Clyde2105/Thesis_FYP/Photos of Tests/Tests Photos/MediaPipe/Hand Landmarks working300.png

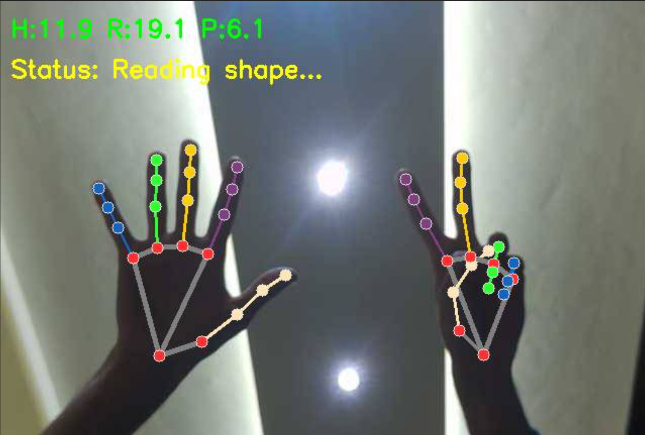
Photos of Tests/Tests Photos/MediaPipe/Hand Landmarks working300.png
