Clyde2105/Thesis_FYP/Photos of Tests/Tests Photos/Line/94aa3fa5-1989-4feb-a9e3-814e40652d71.jpg

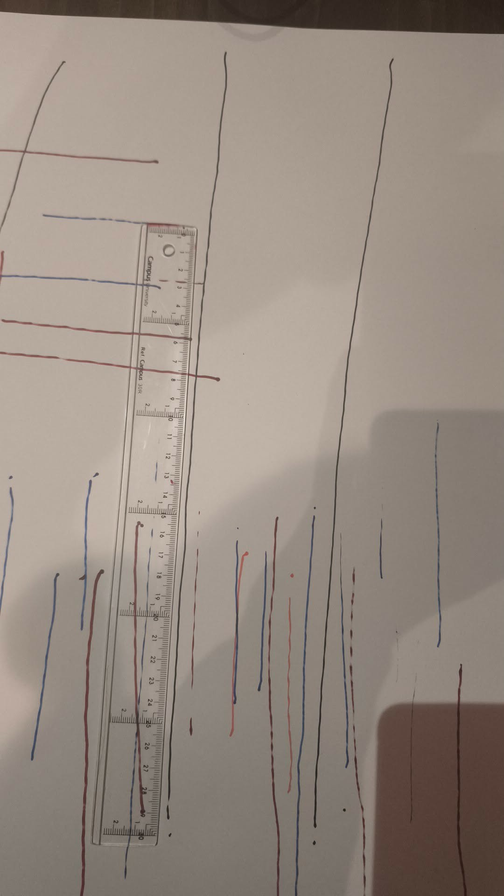
Photos of Tests/Tests Photos/Line/94aa3fa5-1989-4feb-a9e3-814e40652d71.jpg
