Clyde2105/Thesis_FYP/Photos of Tests/Tests Photos/Robot on Big Paper.jpg

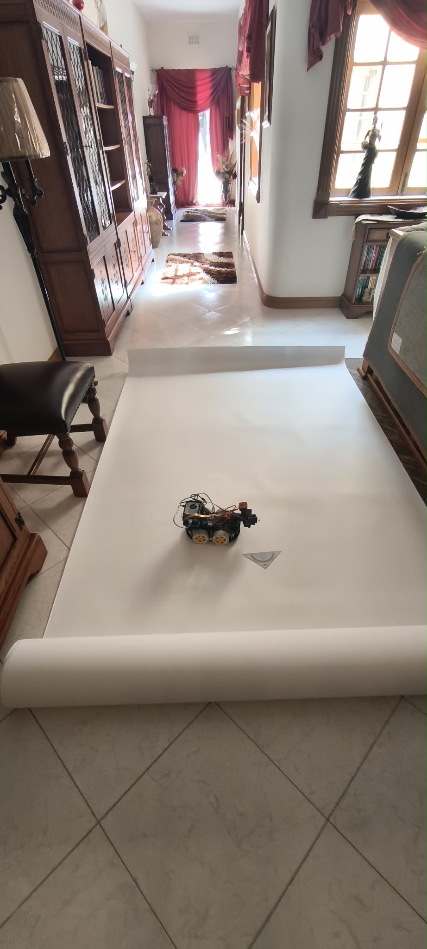
Photos of Tests/Tests Photos/Robot on Big Paper.jpg
