Clyde2105/Thesis_FYP/Photos of Tests/Tests Photos/measure shape setup.jpg

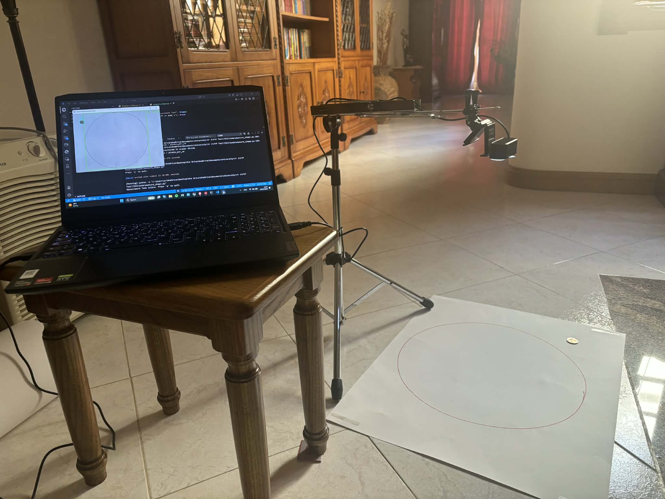
Photos of Tests/Tests Photos/measure shape setup.jpg
