Clyde2105/Thesis_FYP/Results/Thesis Results/Distance Test Results.xlsx

Distance (cm) | Trial Number | Intended Shape | Shape Read | Success (1 or 0) | Notes
30 | 1 | Circle | Circle | 1 | Stable - bit too close to the camera (45cm min is the best)
30 | 2 | Line | Line | 1 | Stable - bit too close to the camera (45cm min is the best)
30 | 3 | Rectangle | Rectangle | 1 | Stable - bit too close to the camera (45cm min is the best)
30 | 4 | Triangle | Triangle | 1 | Stable - bit too close to the camera (45cm min is the best)
30 | 5 | Square | Square | 1 | Stable - bit too close to the camera (45cm min is the best)
30 | 6 | Star | Star | 1 | Stable - bit too close to the camera (45cm min is the best) | Distance (X-Axis) | Accuracy % (Y-Axis)
60 | 1 | Circle | Circle | 1 | Stable | 30 | 100
60 | 2 | Line | Line | 1 | Stable | 60 | 100
60 | 3 | Rectangle | Rectangle | 1 | Stable | 90 | 100
60 | 4 | Triangle | Triangle | 1 | Stable | 120 | 100
60 | 5 | Square | Square | 1 | Stable | 200 | 100
60 | 6 | Star | Star | 1 | Stable | 300 | 100
90 | 1 | Circle | Circle | 1 | Stable
90 | 2 | Line | Line | 1 | Stable
90 | 3 | Rectangle | Rectangle | 1 | Stable
90 | 4 | Triangle | Triangle | 1 | Stable
90 | 5 | Square | Square | 1 | Stable
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
