Clyde2105/Thesis_FYP/Results/Thesis Results/BNO055/BNO055 Tests.xlsx

Time | Heading Angle | Target | Average | Min | Max | StdDev | Upper | Lower
0 | 0 | 0 | 0 | 0 | 0 | 0 | 0 | 0
0.5 | 0 | 30 | 28.75 | 28.75 | 28.75 | 0 | 0 | 0
1 | 0 | 60 | 59.12 | 59.12 | 59.12 | 0 | 0 | 0
1.5 | 0 | 90 | 89.12 | 89.12 | 89.12 | 0 | 0 | 0
2 | 0 | 120 | 118.25 | 118.25 | 118.25 | 0 | 0 | 0
2.5 | 0 | 150 | 147.5 | 147.5 | 147.5 | 0 | 0 | 0
3 | 0 | 180 | 178.01 | 177.94 | 178.06 | 0.06 | 0.05 | 0.07
3.5 | 0
4 | 0
4.5 | 0
5 | 0
5.5 | 0
6 | 0
6.5 | 0
7 | 0
7.5 | 0
8 | 0
8.5 | 0
9 | 0
9.5 | 0
10 | 0
10.5 | 0
11 | 0
11.5 | 0
12 | 0
12.6 | 0
13.1 | 0
13.6 | 0
14.1 | 0
14.6 | 0
15.1 | 0
15.6 | 0
16.1 | 0
16.6 | 0
17.1 | 0
17.6 | 0
18.1 | 0
18.6 | 0
19.1 | 0
19.6 | 0
20.1 | 0
20.6 | 0
21.1 | 0
21.6 | 0
22.1 | 0
22.6 | 0
23.1 | 0
23.6 | 0
24.1 | 0
24.6 | 0
25.1 | 0
25.6 | 0
26.1 | 0
26.6 | 0
27.1 | 0
27.6 | 0
28.1 | 0
28.6 | 0
29.1 | 0
29.6 | 0
30.1 | 0
30.6 | 0
31.1 | 0
31.6 | 0
32.1 | 0
32.6 | 0
33.1 | 0
33.6 | 0
34.1 | 0
34.6 | 0
35.1 | 0
35.6 | 0
36.1 | 0
36.7 | 0
37.2 | 0
37.7 | 0
38.2 | 0
38.7 | 0
39.2 | 0
39.7 | 0
40.2 | 0
40.7 | 0
41.2 | 0
41.7 | 0
42.2 | 0
42.7 | 0
43.2 | 0
43.7 | 0
44.2 | 0
44.7 | 0
45.2 | 0
45.7 | 0
46.2 | 0
46.7 | 0
47.2 | 0
47.7 | 0
48.2 | 0
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
