Clyde2105/Thesis_FYP/Results/Thesis Results/Gesture Accuracy Results.xlsx

Trial Number | Shape Given | Shape Read | Hand Gestures | Trial Number | Shape Given | Shape Read | Hand Gestures |  | Trial Number | Shape Given | Shape Read | Hand Gestures
1 | Circle | Circle | Fist - Palm Side - Physical | 1 | Line | Line | Thumb - Palm Side - Physical |  | 1 | Rectangle | Rectangle | Thumb + Index - Palm Side - Physical
2 | Circle | Circle | Fist - Palm Side - Physical | 2 | Line | Line | Index - Palm Side - Physical |  | 2 | Rectangle | Rectangle | Thumb + Middle - Palm Side - Physical
3 | Circle | Circle | Fist - Palm Side - Physical | 3 | Line | Line | Middle - Palm Side - Physical |  | 3 | Rectangle | Rectangle | Thumb + Ring - Palm Side - Physical
4 | Circle | Circle | Fist - Palm Side - Physical | 4 | Line | Line | Ring - Palm Side - Physical |  | 4 | Rectangle | Rectangle | Thumb + Pinky - Palm Side - Physical
5 | Circle | Circle | Fist - Palm Side - Physical | 5 | Line | Line | Pinky - Palm Side - Physical |  | 5 | Rectangle | Rectangle | Index + Middle - Palm Side - Physical
6 | Circle | Circle | Fist - Palm Side - Online | 6 | Line | Line | Thumb - Palm Side - Online |  | 6 | Rectangle | Rectangle | Index + Ring - Palm Side - Physical
7 | Circle | Circle | Fist - Palm Side - Online | 7 | Line | Line | Index - Palm Side - Online |  | 7 | Rectangle | Rectangle | Index + Pinky - Palm Side - Physical
8 | Circle | Circle | Fist - Palm Side - Online | 8 | Line | Line | Middle - Palm Side - Online |  | 8 | Rectangle | Rectangle | Middle + Ring - Palm Side - Physical
9 | Circle | Circle | Fist - Palm Side - Online | 9 | Line | Line | Ring - Palm Side - Online |  | 9 | Rectangle | Rectangle | Middle + Pinky - Palm Side - Physical
10 | Circle | Circle | Fist - Palm Side - Online | 10 | Line | Line | Pinky - Palm Side - Online |  | 10 | Rectangle | Rectangle | Ring + Pinky - Palm Side - Physical
11 | Circle | Line | Fist - Back Side - Physical | 11 | Line | Circle | Thumb - Back Side - Physical |  | 11 | Rectangle | Rectangle | Thumb + Index - Palm Side - Online
12 | Circle | Line | Fist - Back Side - Physical | 12 | Line | Rectangle | Index - Back Side - Physical |  | 12 | Rectangle | Rectangle | Thumb + Middle - Palm Side - Online
13 | Circle | Line | Fist - Back Side - Physical | 13 | Line | Rectangle | Middle - Back Side - Physical |  | 13 | Rectangle | Rectangle | Thumb + Ring - Palm Side - Online
14 | Circle | Line | Fist - Back Side - Physical | 14 | Line | Rectangle | Ring - Back Side - Physical |  | 14 | Rectangle | Rectangle | Thumb + Pinky - Palm Side - Online
15 | Circle | Line | Fist - Back Side - Physical | 15 | Line | Rectangle | Pinky - Back Side - Online |  | 15 | Rectangle | Rectangle | Index + Middle - Palm Side - Online
16 | Circle | Line | Fist - Back Side - Online | 16 | Line | Circle | Thumb - Back Side - Online |  | 16 | Rectangle | Rectangle | Index + Ring - Palm Side - Online
17 | Circle | Line | Fist - Back Side - Online | 17 | Line | Rectangle | Index - Back Side - Online |  | 17 | Rectangle | Rectangle | Index + Pinky - Palm Side - Online
18 | Circle | Line | Fist - Back Side - Online | 18 | Line | Rectangle | Middle - Back Side - Online |  | 18 | Rectangle | Rectangle | Middle + Ring - Palm Side - Online
19 | Circle | Line | Fist - Back Side - Online | 19 | Line | Rectangle | Ring - Back Side - Online |  | 19 | Rectangle | Rectangle | Middle + Pinky - Palm Side - Online
20 | Circle | Line | Fist - Back Side - Online | 20 | Line | Rectangle | Pinky - Back Side - Online |  | 20 | Rectangle | Rectangle | Ring + Pinky - Palm Side - Online
 |  |  |  |  |  |  |  |  | 21 | Rectangle | Line | Thumb + Pinky - Back Side - Physical
 |  |  |  |  |  |  |  |  | 22 | Rectangle | Triangle | Index + Middle - Back Side - Physical
 |  |  |  |  |  |  |  |  | 23 | Rectangle | Line | Thumb + Middle - Back Side - Physical
 |  |  |  |  |  |  |  |  | 24 | Rectangle | Square | Index + Ring - Back Side - Physical
 |  |  |  |  |  |  |  |  | 25 | Rectangle | Triangle | Middle + Pinky - Back Side - Physical
Trial Number | Shape Given | Shape Read | Hand Gestures | Trial Number | Shape Given | Shape Read | Hand Gestures |  | Trial Number | Shape Given | Shape Read | Hand Gestures
1 | Triangle | Triangle | Thumb + Index + Middle - Palm Side - Physical | 1 | Square | Square | Thumb + Index + Middle + Ring - Palm Side - Physical |  | 1 | Star | Star | Open Hand - Palm Side - Physical
2 | Triangle | Triangle | Thumb + Index + Ring - Palm Side - Physical | 2 | Square | Square | Thumb + Index + Middle + Pinky - Palm Side - Physical |  | 2 | Star | Star | Open Hand - Palm Side - Physical
3 | Triangle | Triangle | Thumb + Index + Pinky - Palm Side - Physical | 3 | Square | Square | Thumb + Index + Ring + Pinky - Palm Side - Physical |  | 3 | Star | Star | Open Hand - Palm Side - Physical
4 | Triangle | Triangle | Thumb + Middle + Ring - Palm Side - Physical | 4 | Square | Square | Thumb + Middle + Ring + Pinky - Palm Side - Physical |  | 4 | Star | Star | Open Hand - Palm Side - Physical
5 | Triangle | Triangle | Thumb + Middle + Pinky - Palm Side - Physical | 5 | Square | Square | Index + Middle + Ring + Pinky - Palm Side - Physical |  | 5 | Star | Star | Open Hand - Palm Side - Physical
6 | Triangle | Triangle | Thumb + Ring + Pinky - Palm Side - Physical | 6 | Square | Square | Thumb + Index + Middle + Ring - Palm Side - Online |  | 6 | Star | Star | Open Hand - Palm Side - Online
7 | Triangle | Triangle | Index + Middle + Ring - Palm Side - Physical | 7 | Square | Square | Thumb + Index + Middle + Pinky - Palm Side - Online |  | 7 | Star | Star | Open Hand - Palm Side - Online
8 | Triangle | Triangle | Index + Middle + Pinky - Palm Side - Physical | 8 | Square | Square | Thumb + Index + Ring + Pinky - Palm Side - Online |  | 8 | Star | Star | Open Hand - Palm Side - Online
9 | Triangle | Triangle | Index + Ring + Pinky - Palm Side - Physical | 9 | Square | Square | Thumb + Middle + Ring + Pinky - Palm Side - Online |  | 9 | Star | Star | Open Hand - Palm Side - Online
10 | Triangle | Triangle | Middle + Ring + Pinky - Palm Side - Physical | 10 | Square | Square | Index + Middle + Ring + Pinky - Palm Side - Online |  | 10 | Star | Star | Open Hand - Palm Side - Online
11 | Triangle | Triangle | Thumb + Index + Middle - Palm Side - Online | 11 | Square | Square | Thumb + Index + Middle + Ring - Back Side - Physical |  | 11 | Star | Square | Open Hand - Back Side - Physical
12 | Triangle | Triangle | Thumb + Index + Ring - Palm Side - Online | 12 | Square | Triangle | Thumb + Index + Middle + Pinky - Back Side - Physical |  | 12 | Star | Square | Open Hand - Back Side - Physical
13 | Triangle | Triangle | Thumb + Index + Pinky - Palm Side - Online | 13 | Square | Triangle | Thumb + Index + Ring + Pinky - Back Side - Physical |  | 13 | Star | Square | Open Hand - Back Side - Physical
14 | Triangle | Triangle | Thumb + Middle + Ring - Palm Side - Online | 14 | Square | Triangle | Thumb + Middle + Ring + Pinky - Back Side - Physical |  | 14 | Star | Square | Open Hand - Back Side - Physical
15 | Triangle | Triangle | Thumb + Middle + Pinky - Palm Side - Online | 15 | Square | Star | Index + Middle + Ring + Pinky - Back Side - Physical |  | 15 | Star | Square | Open Hand - Back Side - Physical
16 | Triangle | Triangle | Thumb + Ring + Pinky - Palm Side - Online | 16 | Square | Square | Thumb + Index + Middle + Ring - Back Side - Online |  | 16 | Star | Square | Open Hand - Back Side - Online
17 | Triangle | Triangle | Index + Middle + Ring - Palm Side - Online | 17 | Square | Triangle | Thumb + Index + Middle + Pinky - Back Side - Online |  | 17 | Star | Square | Open Hand - Back Side - Online
18 | Triangle | Triangle | Index + Middle + Pinky - Palm Side - Online | 18 | Square | Triangle | Thumb + Index + Ring + Pinky - Back Side - Online |  | 18 | Star | Square | Open Hand - Back Side - Online
19 | Triangle | Triangle | Index + Ring + Pinky - Palm Side - Online | 19 | Square | Triangle | Thumb + Middle + Ring + Pinky - Back Side - Online |  | 19 | Star | Square | Open Hand - Back Side - Online
20 | Triangle | Triangle | Middle + Ring + Pinky - Palm Side - Online | 20 | Square | Star | Index + Middle + Ring + Pinky - Back Side - Online |  | 20 | Star | Square | Open Hand - Back Side - Online
21 | Triangle | Rectangle | Thumb + Index + Middle - Back Side - Physical
22 | Triangle | Rectangle | Thumb + Index + Ring - Back Side - Physical
23 | Triangle | Rectangle | Thumb + Index + Pinky - Back Side - Physical
24 | Triangle | Rectangle | Thumb + Middle + Ring - Back Side - Physical
25 | Triangle | Rectangle | Thumb + Middle + Pinky - Back Side - Physical |  | Actual \ Predicted | Circle | Line | Rectangle | Triangle | Square | Star | Total Trials
26 | Triangle | Rectangle | Thumb + Ring + Pinky - Back Side - Physical |  | Circle (0) | 10 | 10 | 0 | 0 | 0 | 0 | 20
27 | Triangle | Square | Index + Middle + Ring - Back Side - Physical |  | Line (1) | 2 | 10 | 8 | 0 | 0 | 0 | 20
28 | Triangle | Square | Index + Middle + Pinky - Back Side - Physical |  | Rectangle (2) | 0 | 2 | 20 | 2 | 1 | 0 | 25
29 | Triangle | Square | Index + Ring + Pinky - Back Side - Physical |  | Triangle (3) | 0 | 0 | 6 | 20 | 4 | 0 | 30
30 | Triangle | Square | Middle + Ring + Pinky - Back Side - Physical |  | Square (4) | 0 | 0 | 0 | 6 | 12 | 2 | 20
 |  |  |  |  | Star (5) | 0 | 0 | 0 | 0 | 10 | 10 | 20
(Back of Hand showing, reads thumb incorrectly and adds one to readings) |  |  |  |  | Total Predicted | 12 | 22 | 34 | 28 | 27 | 12 | 135
For example, 0 fingers up with back hand is Line since it misclassifies as thumb up!
