Clyde2105/Thesis_FYP/Results/Thesis Results/LM393/LM393 Tests.xlsx

Time (ms) | LeftTicks | RightTicks | LeftVelocity | RightVelocity | Sample No. | Test 1 Left Ticks | Test 1 Right Ticks | Test 2 Left Ticks | Test 2 Right Ticks | Test 3 Left Ticks | Test 3 Right Ticks | Test 4 Left Ticks | Test 4 Right Ticks | Test 5 Left Ticks | Test 5 Right Ticks
0 | 0 | 0 | 0 | 0 | 1 | 0 | 0 | 0 | 0 | 0 | 0 | 0 | 0 | 0 | 0
100 | 2 | 4 | 2 | 4 | 2 | 0 | 0 | 0 | 0 | 0 | 0 | 0 | 0 | 2 | 0
200 | 6 | 8 | 4 | 4 | 3 | 0 | 0 | 1 | 1 | 1 | 1 | 1 | 1 | 2 | 0
300 | 10 | 12 | 4 | 4 | 4 | 0 | 0 | 1 | 1 | 1 | 1 | 1 | 1 | 2 | 0
400 | 14 | 16 | 4 | 4 | 5 | 1 | 1 | 2 | 2 | 2 | 1 | 2 | 2 | 3 | 0
500 | 19 | 23 | 5 | 7 | 6 | 1 | 1 | 2 | 3 | 3 | 1 | 2 | 2 | 3 | 0
600 | 25 | 27 | 6 | 4 | 7 | 1 | 1 | 2 | 3 | 3 | 2 | 2 | 2 | 3 | 0
700 | 33 | 31 | 8 | 4 | 8 | 2 | 2 | 3 | 4 | 4 | 3 | 3 | 3 | 4 | 1
800 | 39 | 35 | 6 | 4 | 9 | 3 | 2 | 3 | 4 | 4 | 3 | 4 | 3 | 4 | 1
900 | 46 | 39 | 7 | 4 | 10 | 4 | 3 | 4 | 5 | 5 | 4 | 5 | 4 | 4 | 1
1000 | 50 | 44 | 4 | 5 | 11 | 4 | 3 | 4 | 6 | 5 | 4 | 5 | 4 | 5 | 2
1100 | 54 | 48 | 4 | 4 | 12 | 4 | 3 | 4 | 6 | 5 | 5 | 5 | 4 | 5 | 2
1200 | 59 | 53 | 5 | 5 | 13 | 5 | 4 | 5 | 7 | 6 | 6 | 6 | 5 | 6 | 2
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
