Clyde2105/Thesis_FYP/Results/Thesis Results/Light Intensity Test Results.xlsx

Lighting Condition | Trial Number | Intended Shape | Shape Read | Success (1 or 0) | Notes | Lighting Condition | Accuracy (%)
Fully Lit | 1 | Circle | Circle | 1 | Stable | Fully Lit (Standard) | 100%
Fully Lit | 2 | Line | Line | 1 | Stable | Background Lit (Backlit) | 100%
Fully Lit | 3 | Rectangle | Rectangle | 1 | Stable | Dimmly Lit (Low Light) | 0%
Fully Lit | 4 | Triangle | Triangle | 1 | Stable
Fully Lit | 5 | Square | Square | 1 | Stable
Fully Lit | 6 | Star | Star | 1 | Stable
Dimmly Lit | 1 | Circle | Nothing | 0 | Not stable - barely reading one hand
Dimmly Lit | 2 | Line | Nothing | 0 | Not stable - barely reading one hand
Dimmly Lit | 3 | Rectangle | Nothing | 0 | Not stable - barely reading one hand
Dimmly Lit | 4 | Triangle | Nothing | 0 | Not stable - barely reading one hand
Dimmly Lit | 5 | Square | Nothing | 0 | Not stable - barely reading one hand
Dimmly Lit | 6 | Star | Nothing | 0 | Not stable - barely reading one hand
Background Lit | 1 | Circle | Circle | 1 | Stable
Background Lit | 2 | Line | Line | 1 | Stable
Background Lit | 3 | Rectangle | Rectangle | 1 | Stable
Background Lit | 4 | Triangle | Triangle | 1 | Stable
Background Lit | 5 | Square | Square | 1 | Stable
Background Lit | 6 | Star | Star | 1 | Stable
