Clyde2105/Thesis_FYP/Results/Thesis Results/Simulation Results Table.xlsx

Shape Name | Dimension (m) | Completion Time (s) | Start Pose (X,Y) | Final Pose (X,Y) | Loop Closure Error (m) | Result
Circle | Radius: 0.5 | 69.38 | (0.004, 0.000) | (-0.020, 0.000) | 0.024 | Successful
Line | Length: 0.5 | 7.43 | (0.000, 0.000) | (0.497, 0.000) | 0.0032 | Successful
Rectangle | Length: 1.0, Width: 0.5 | 97.15 | (0.000, 0.000) | (-0.001, 0.008) | 0.008 | Successful
Triangle | Length: 1.0 | 85.32 | (0.000, 0.000) | (0.000, -0.015) | 0.015 | Successful
Square | Length: 1.0 | 117.55 | (0.000, 0.000) | (0.015, 0.018) | 0.023 | Successful
Star | Length: 1.0 | 171.32 | (0.000, 0.000) | (0.217, 0.012) | 0.217 | Successful
