Clyde2105/Thesis_FYP/Photos of Tests/Simulation Photos/5 Pointed Star Simulation Cropped.png

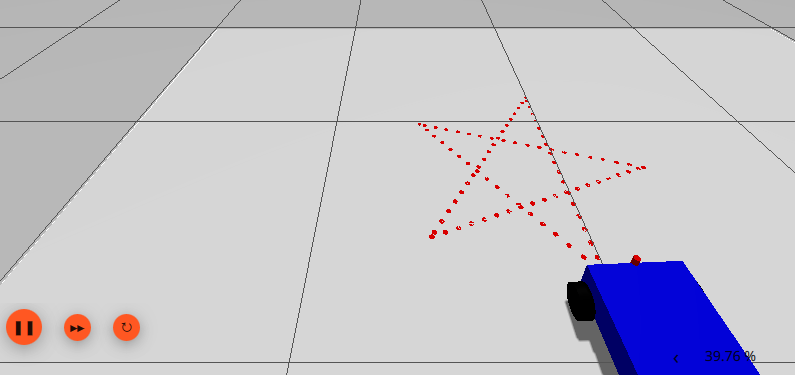
Photos of Tests/Simulation Photos/5 Pointed Star Simulation Cropped.png
