Clyde2105/Thesis_FYP/Photos of Tests/Simulation Photos/Circle Simulation.png

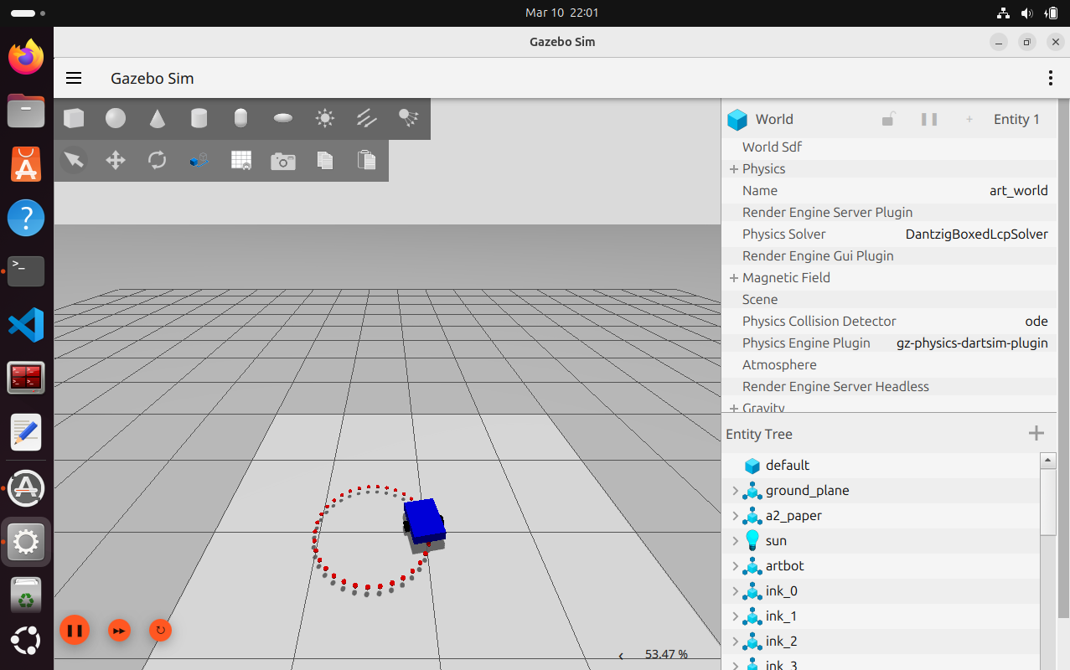
Photos of Tests/Simulation Photos/Circle Simulation.png
