Clyde2105/Thesis_FYP/Photos of Tests/Simulation Photos/Line Simulation.png

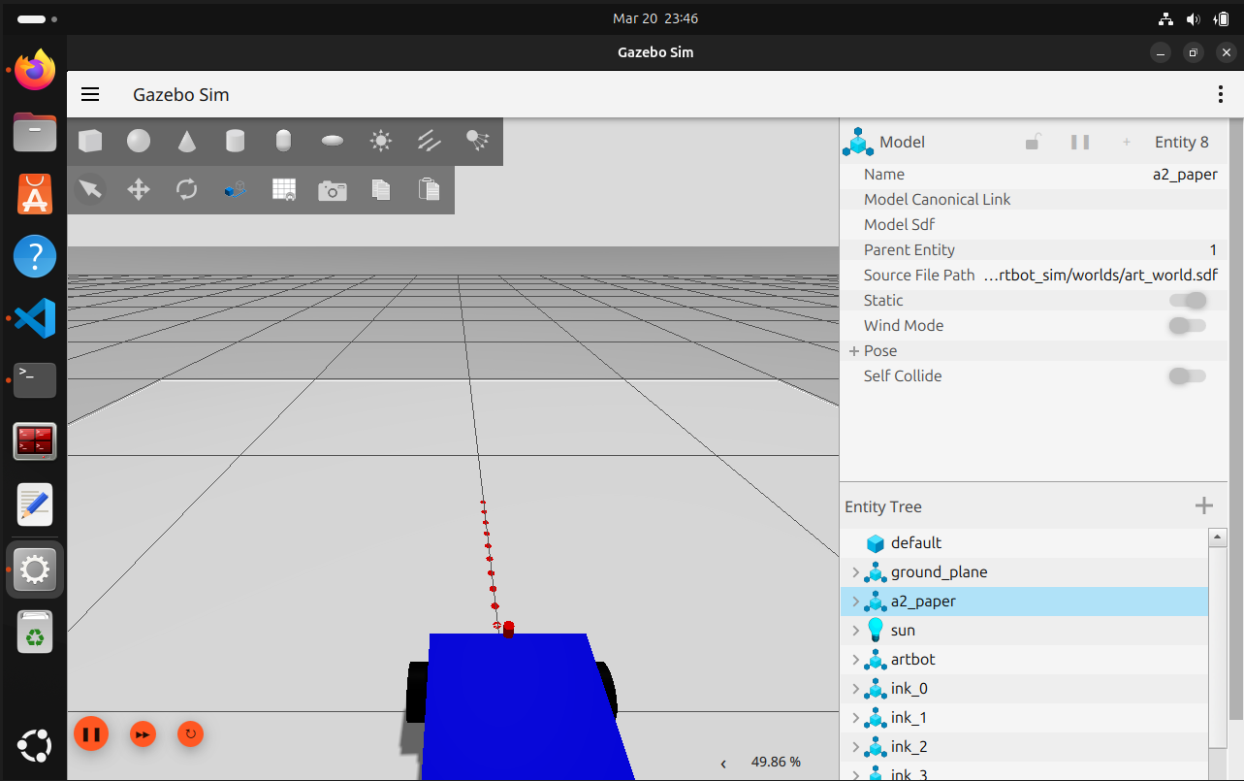
Photos of Tests/Simulation Photos/Line Simulation.png
