Clyde2105/Thesis_FYP/Photos of Tests/Simulation Photos/Rectangle Simulation.png

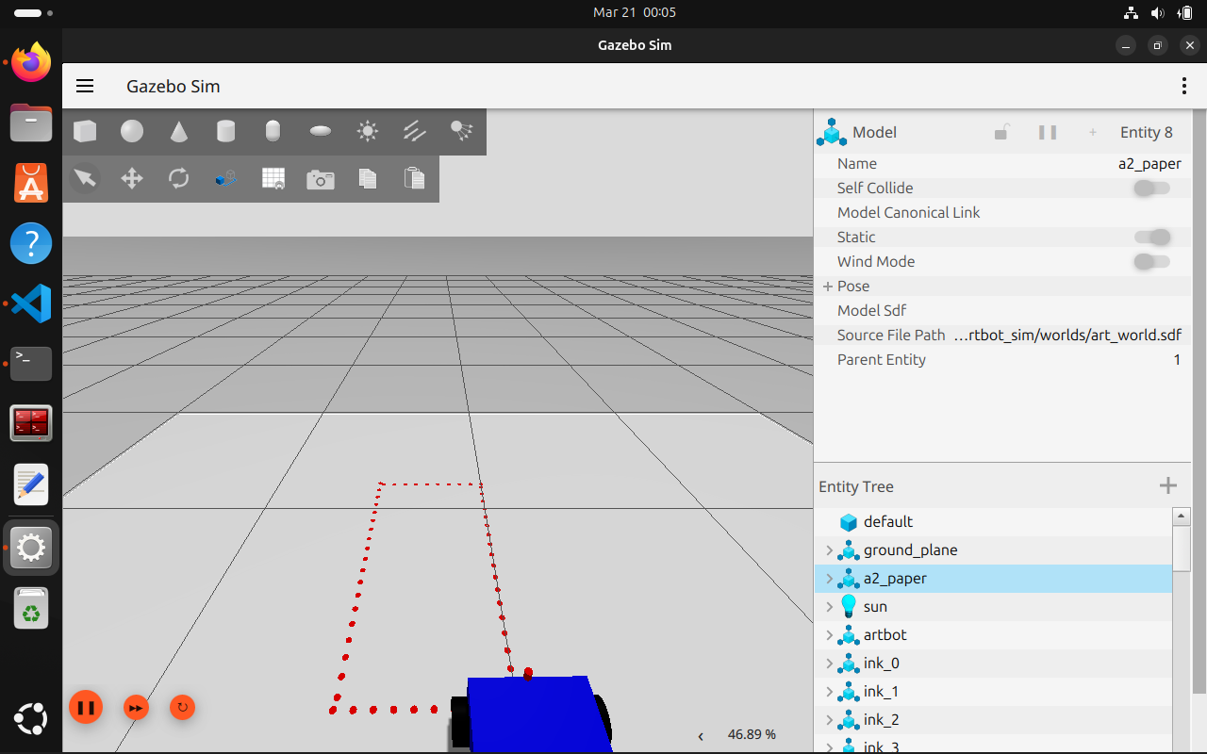
Photos of Tests/Simulation Photos/Rectangle Simulation.png
