Clyde2105/Thesis_FYP/Photos of Tests/Simulation Photos/Simulation Photos All Shapes.png

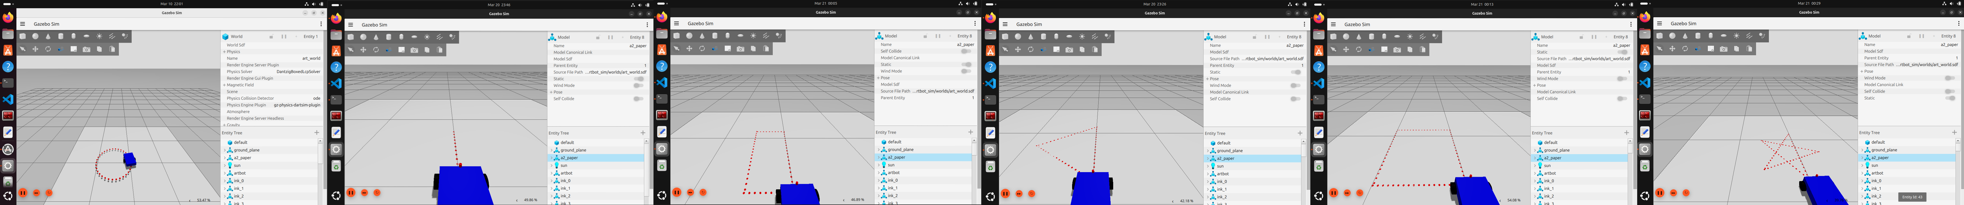
Photos of Tests/Simulation Photos/Simulation Photos All Shapes.png
