Clyde2105/Thesis_FYP/Photos of Tests/Simulation Photos/Square Simulation.png

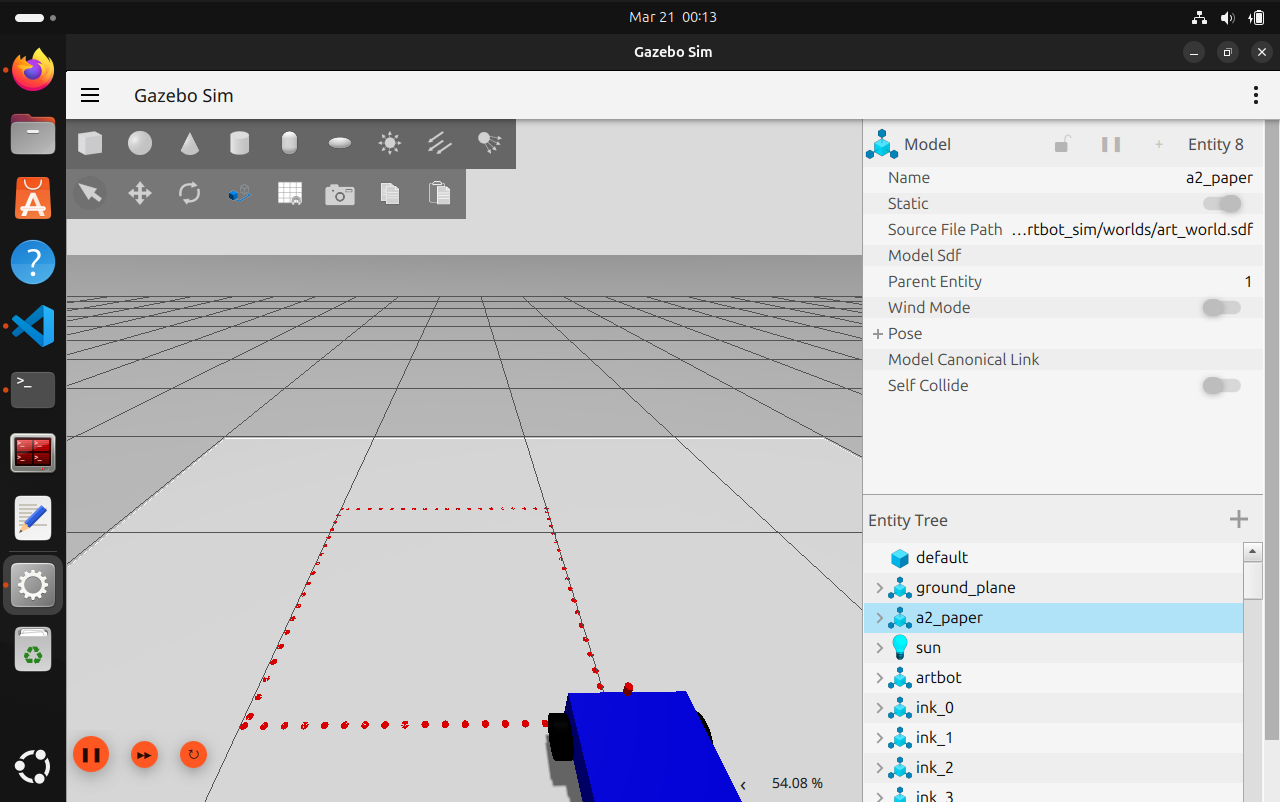
Photos of Tests/Simulation Photos/Square Simulation.png
