Clyde2105/Thesis_FYP/Photos of Tests/Simulation Photos/Triangle Simulation.png

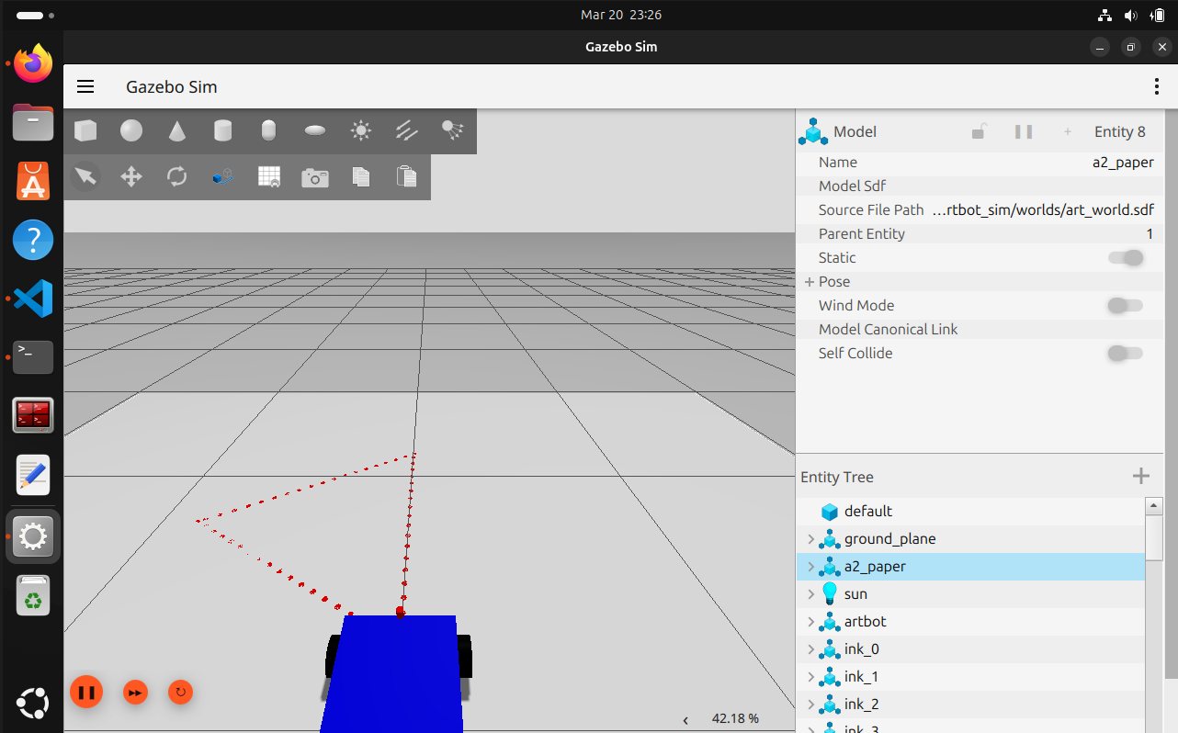
Photos of Tests/Simulation Photos/Triangle Simulation.png
