Clyde2105/Thesis_FYP/Photos of Tests/Tests Photos/5 Pointed Star/Closest to Success Star300.jpg

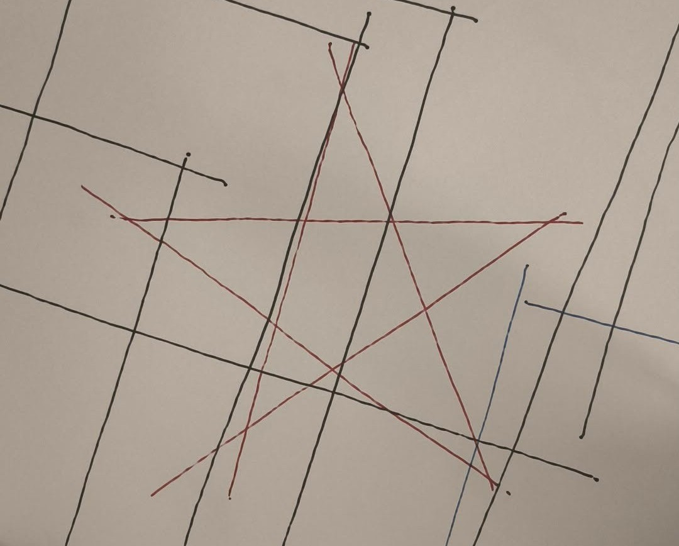
Photos of Tests/Tests Photos/5 Pointed Star/Closest to Success Star300.jpg
