Clyde2105/Thesis_FYP/Photos of Tests/Tests Photos/5 Pointed Star/Star 2.jpg

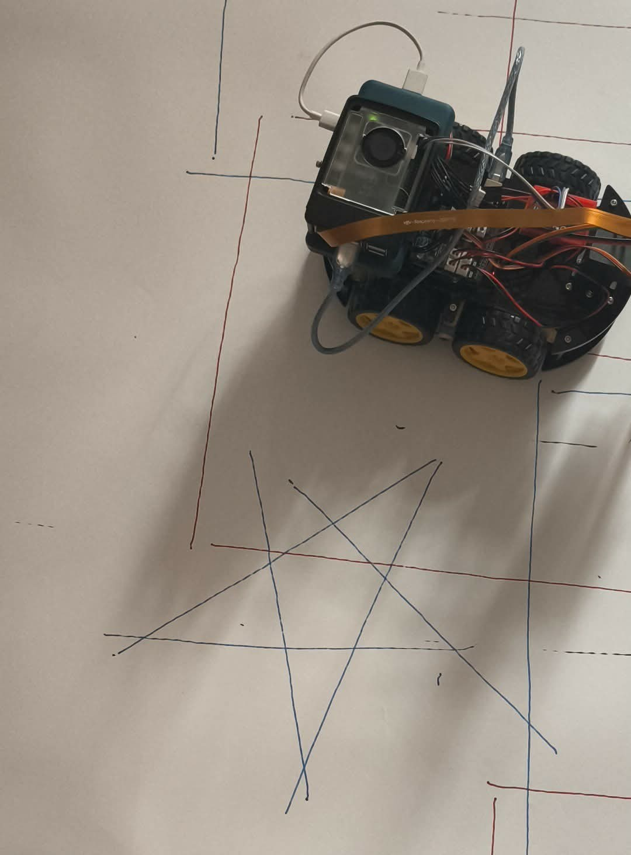
Photos of Tests/Tests Photos/5 Pointed Star/Star 2.jpg
