Clyde2105/Thesis_FYP/Photos of Tests/Tests Photos/Circle/3ffc56f3-8b45-45fe-b545-28d3049bc2e5.jpg

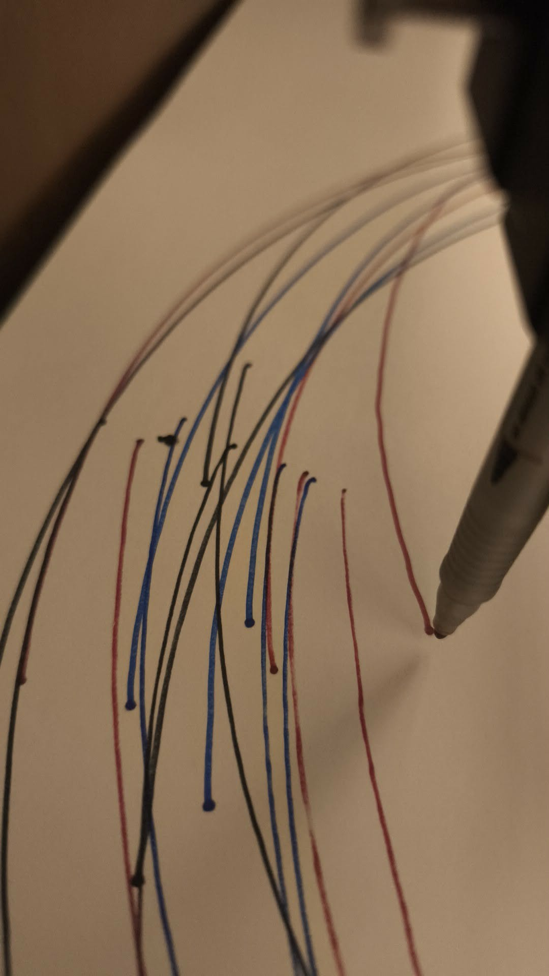
Photos of Tests/Tests Photos/Circle/3ffc56f3-8b45-45fe-b545-28d3049bc2e5.jpg
