Clyde2105/Thesis_FYP/Photos of Tests/Tests Photos/Circle/5d947b5f-b804-485e-b66c-cc5df9e25e5f.jpg

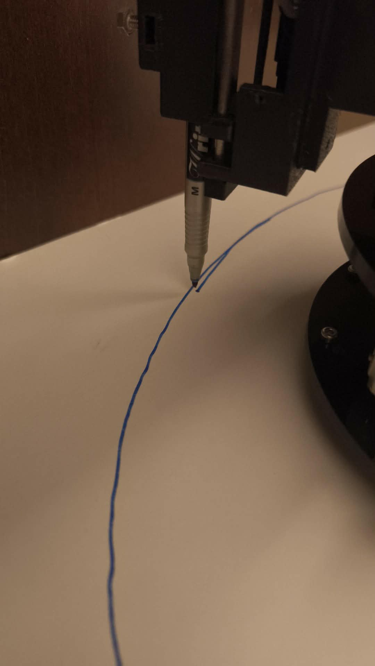
Photos of Tests/Tests Photos/Circle/5d947b5f-b804-485e-b66c-cc5df9e25e5f.jpg
