Clyde2105/Thesis_FYP/Photos of Tests/Tests Photos/Circle/8b516a4b-4ea1-4a7e-8e7a-777fda007684.jpg

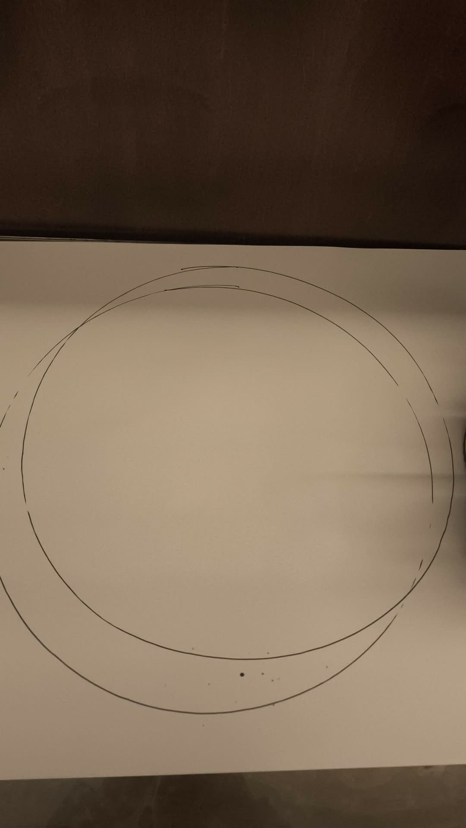
Photos of Tests/Tests Photos/Circle/8b516a4b-4ea1-4a7e-8e7a-777fda007684.jpg
