Clyde2105/Thesis_FYP/Photos of Tests/Tests Photos/Circle/Circle Attempt 2.jpg

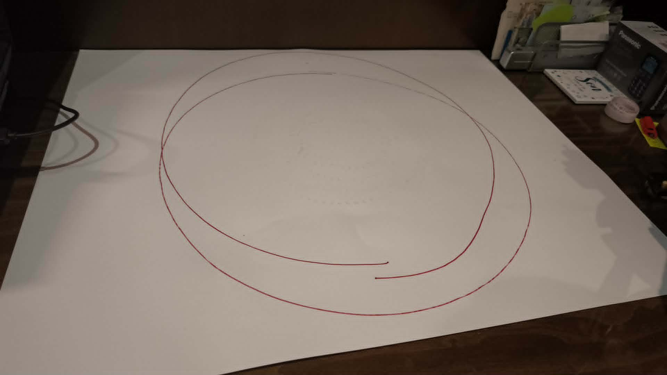
Photos of Tests/Tests Photos/Circle/Circle Attempt 2.jpg
