Clyde2105/Thesis_FYP/Photos of Tests/Tests Photos/Circle/Circle Progress.jpg

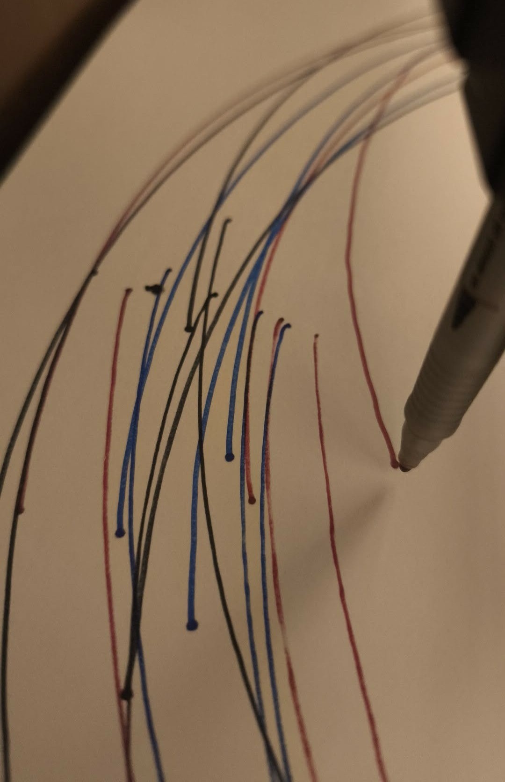
Photos of Tests/Tests Photos/Circle/Circle Progress.jpg
