Clyde2105/Thesis_FYP/Photos of Tests/Tests Photos/Circle/Circle Robot Top View.jpg

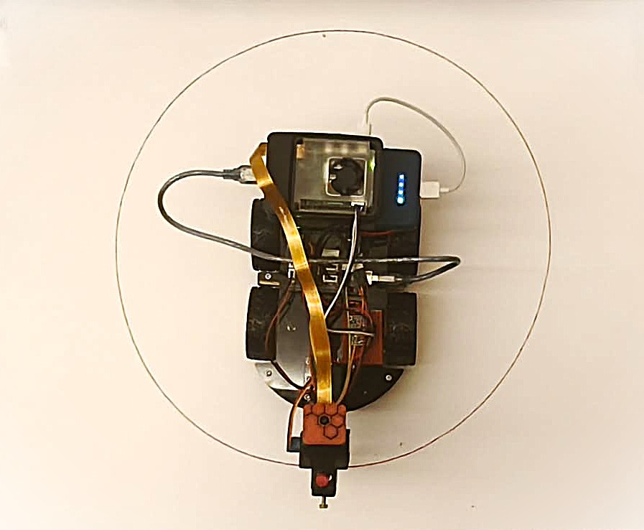
Photos of Tests/Tests Photos/Circle/Circle Robot Top View.jpg
