Clyde2105/Thesis_FYP/Photos of Tests/Tests Photos/Circle/CircleTest2.jpg

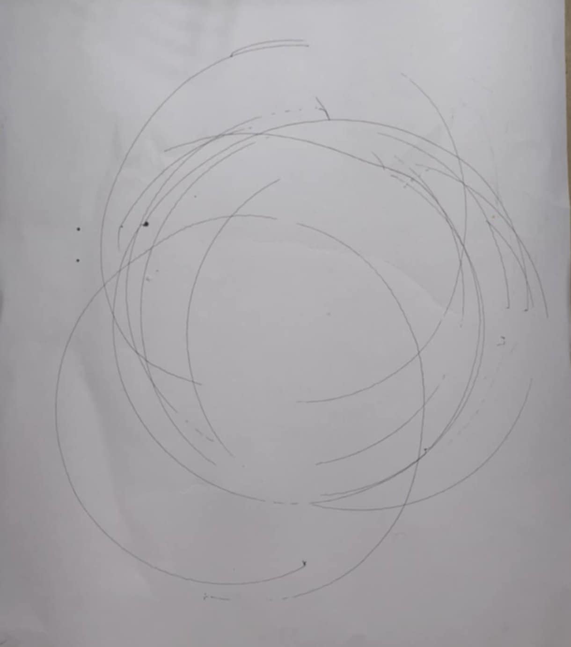
Photos of Tests/Tests Photos/Circle/CircleTest2.jpg
