Clyde2105/Thesis_FYP/Photos of Tests/Tests Photos/Circle/CircleTest.jpg

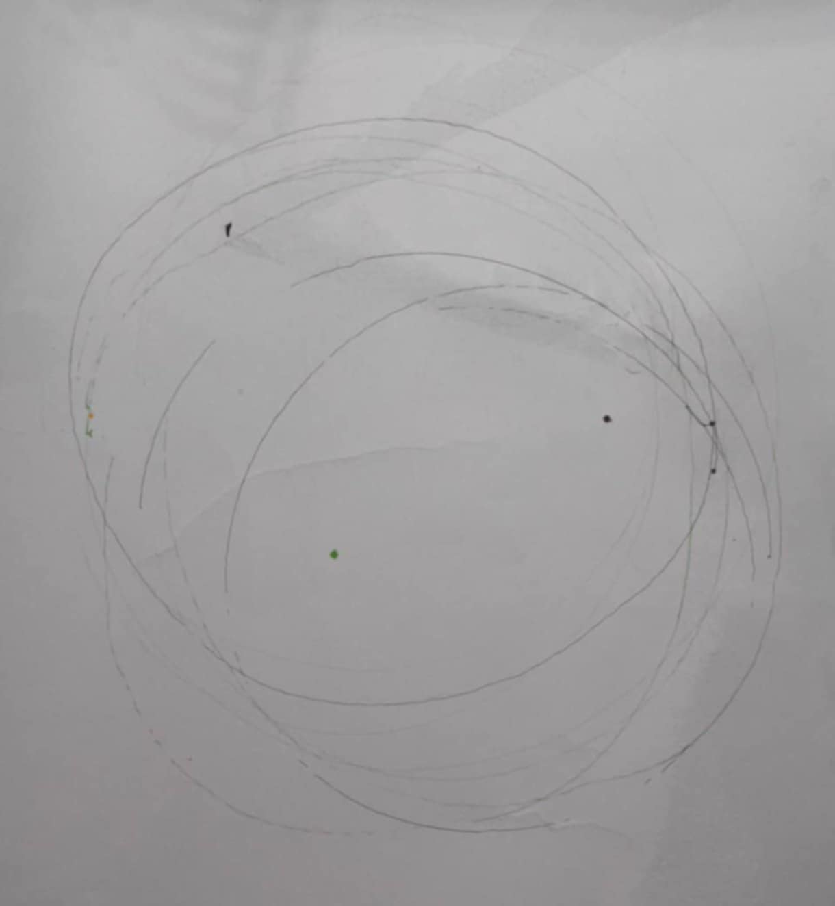
Photos of Tests/Tests Photos/Circle/CircleTest.jpg
