Clyde2105/Thesis_FYP/Photos of Tests/Tests Photos/Circle/e7688110-bd78-485b-a0a9-c3befe19ad73.jpg

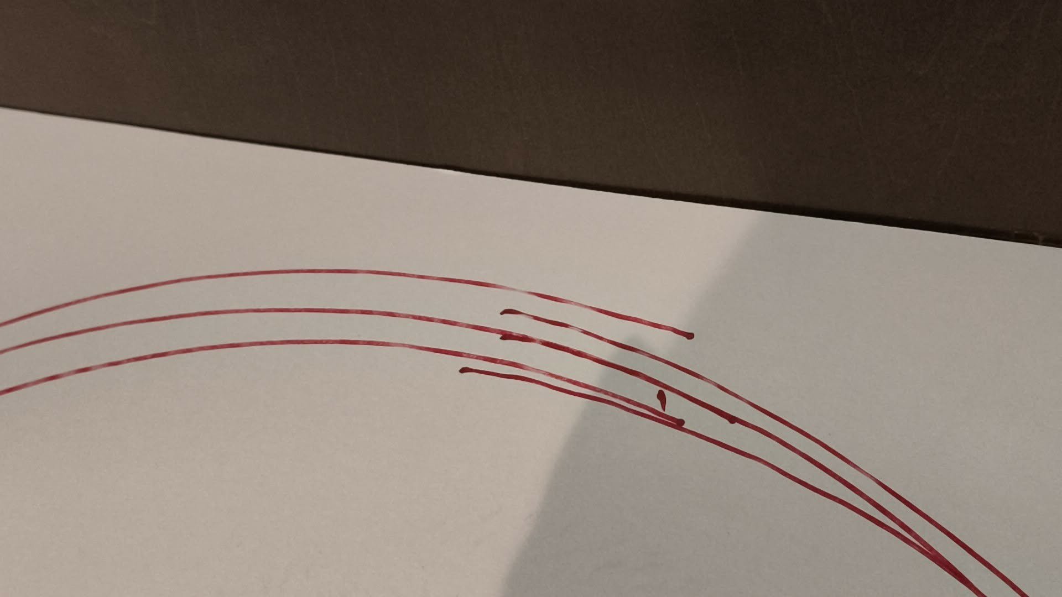
Photos of Tests/Tests Photos/Circle/e7688110-bd78-485b-a0a9-c3befe19ad73.jpg
