Clyde2105/Thesis_FYP/Photos of Tests/Tests Photos/Circle/Successful Circle.jpg

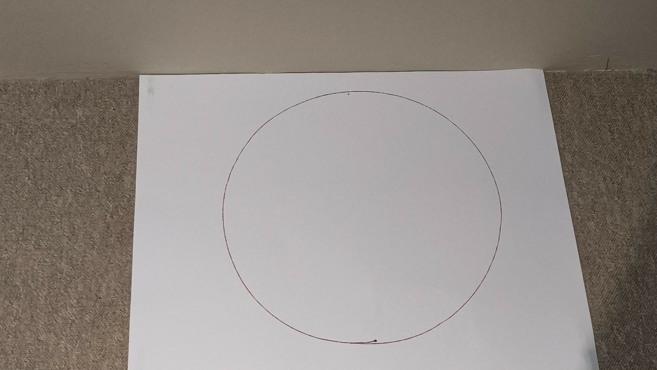
Photos of Tests/Tests Photos/Circle/Successful Circle.jpg
