Clyde2105/Thesis_FYP/Photos of Tests/Tests Photos/Line/6a0cd88d-3087-4550-9019-74efef7cc3c7.jpg

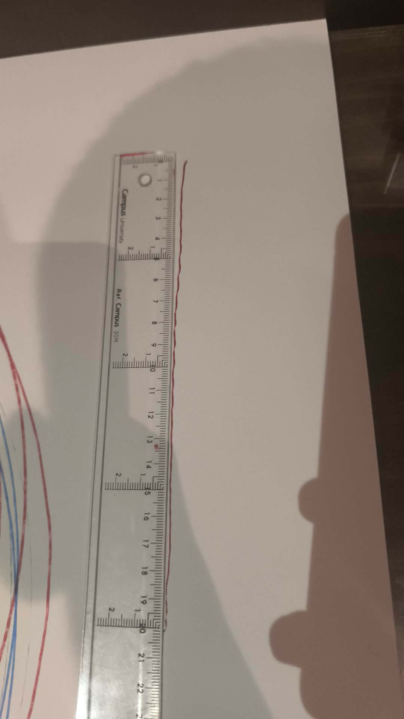
Photos of Tests/Tests Photos/Line/6a0cd88d-3087-4550-9019-74efef7cc3c7.jpg
