Clyde2105/Thesis_FYP/Photos of Tests/Tests Photos/Line/8e45853b-097c-4067-b658-21f27b495928.jpg

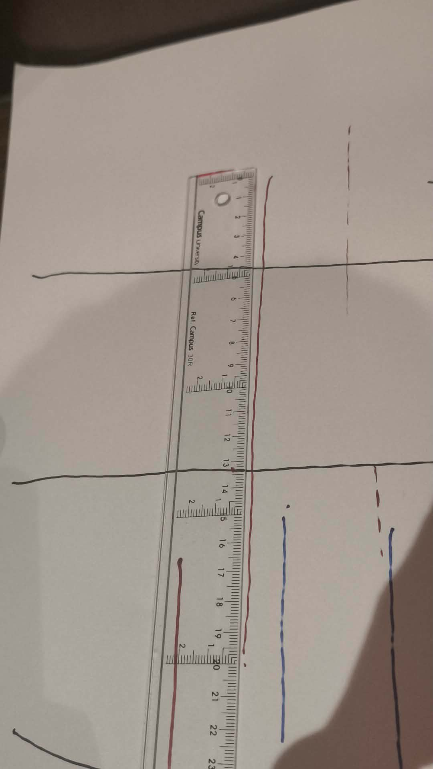
Photos of Tests/Tests Photos/Line/8e45853b-097c-4067-b658-21f27b495928.jpg
