Clyde2105/Thesis_FYP/Photos of Tests/Tests Photos/Line/8f3eb7b3-58f8-402c-a581-3d95e9cdba3d.jpg

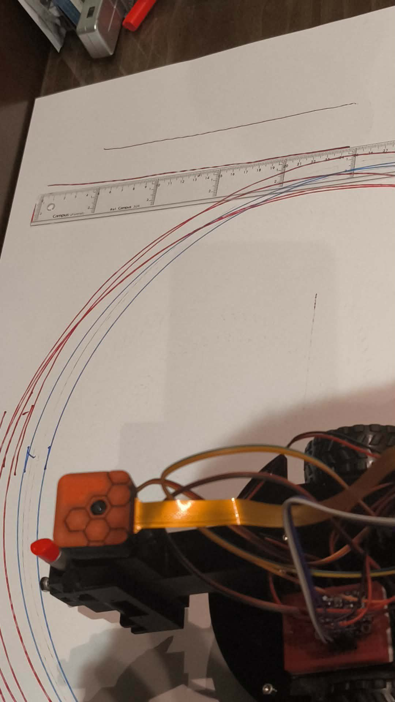
Photos of Tests/Tests Photos/Line/8f3eb7b3-58f8-402c-a581-3d95e9cdba3d.jpg
