Clyde2105/Thesis_FYP/Photos of Tests/Tests Photos/Line/1421cecb-1939-4845-a435-66ea778ed75f.jpg

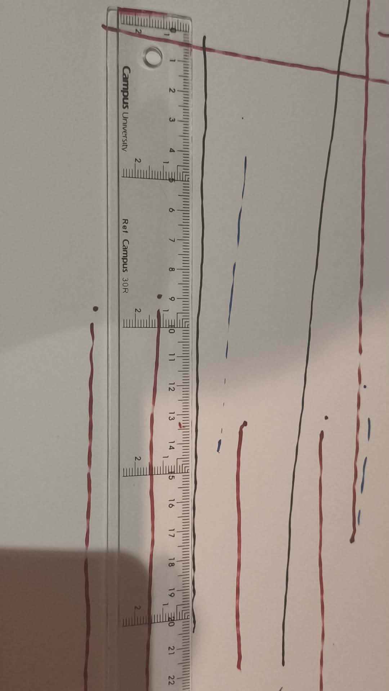
Photos of Tests/Tests Photos/Line/1421cecb-1939-4845-a435-66ea778ed75f.jpg
