Clyde2105/Thesis_FYP/Photos of Tests/Tests Photos/Line/b076c0f0-cd16-419d-92fe-bfb41595d481.jpg

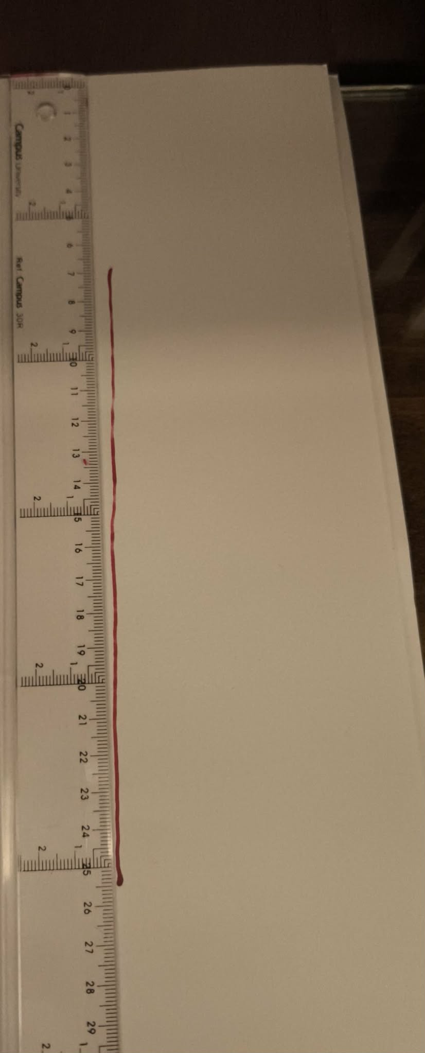
Photos of Tests/Tests Photos/Line/b076c0f0-cd16-419d-92fe-bfb41595d481.jpg
