Clyde2105/Thesis_FYP/Photos of Tests/Tests Photos/Line/be7431b1-883c-4ec3-a1fe-b5d2579155a7.jpg

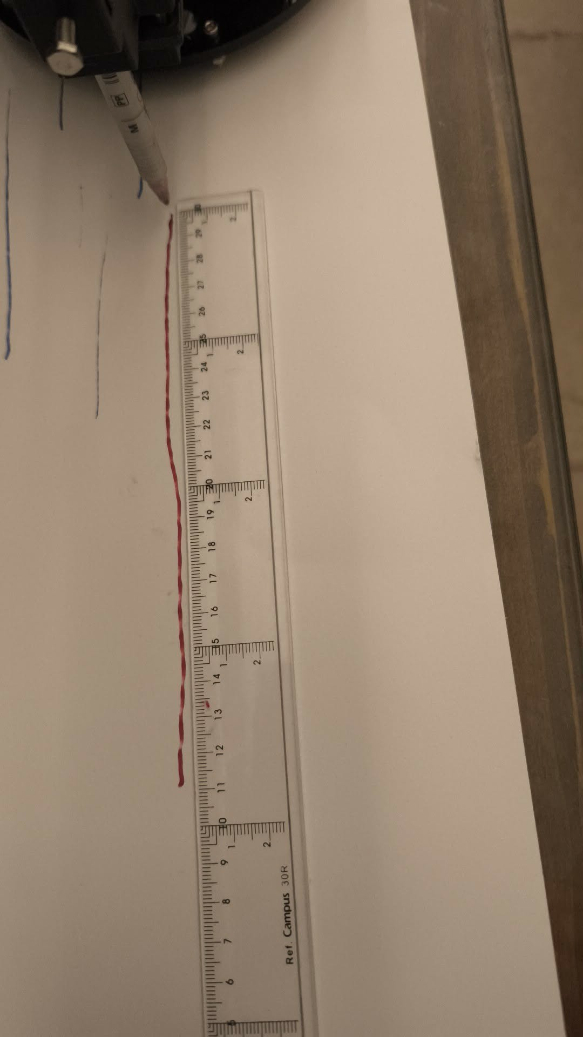
Photos of Tests/Tests Photos/Line/be7431b1-883c-4ec3-a1fe-b5d2579155a7.jpg
