Clyde2105/Thesis_FYP/Photos of Tests/Tests Photos/Line/db3942d4-7437-4874-a197-594e338644d0.jpg

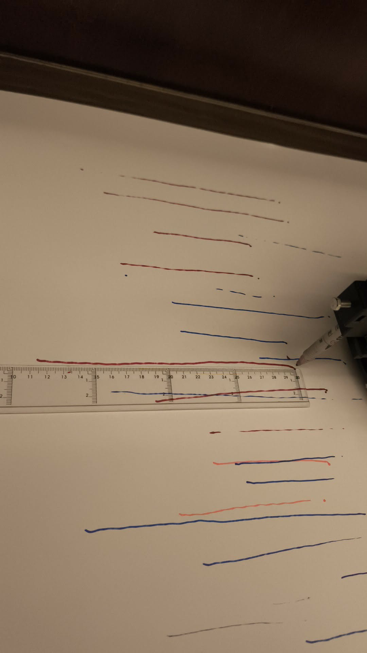
Photos of Tests/Tests Photos/Line/db3942d4-7437-4874-a197-594e338644d0.jpg
