Clyde2105/Thesis_FYP/Photos of Tests/Tests Photos/Line/Line Progress.jpg

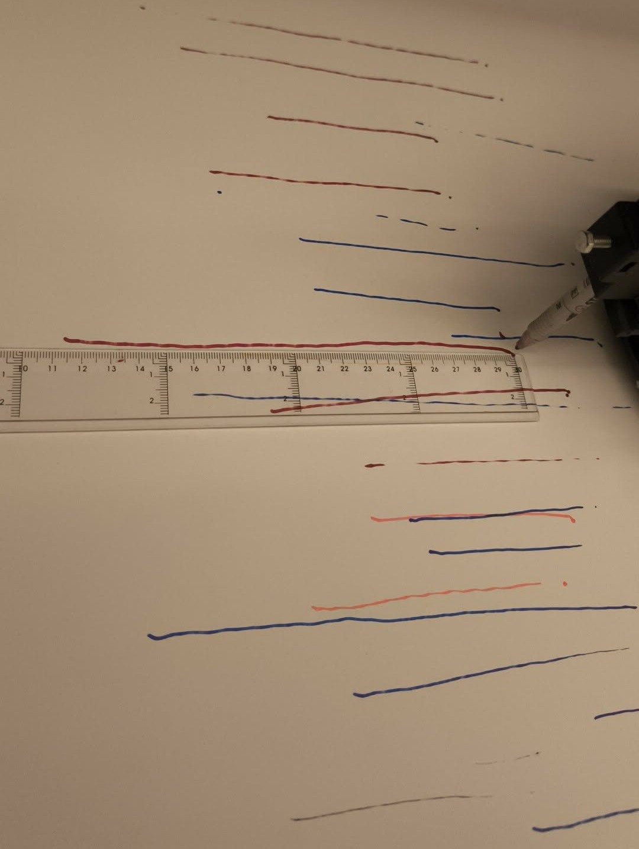
Photos of Tests/Tests Photos/Line/Line Progress.jpg
