Clyde2105/Thesis_FYP/Photos of Tests/Tests Photos/Line/Successful Line300.jpg

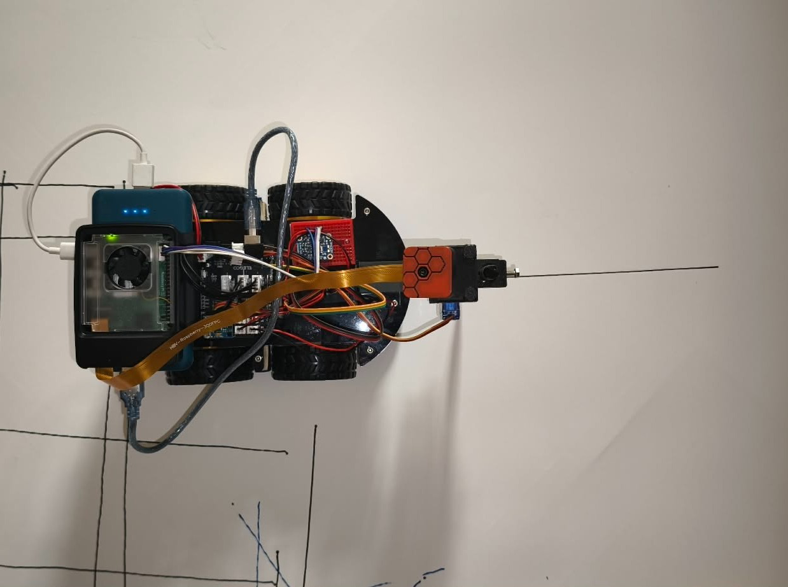
Photos of Tests/Tests Photos/Line/Successful Line300.jpg
