Clyde2105/Thesis_FYP/Photos of Tests/Tests Photos/Line/Successful Line.jpg

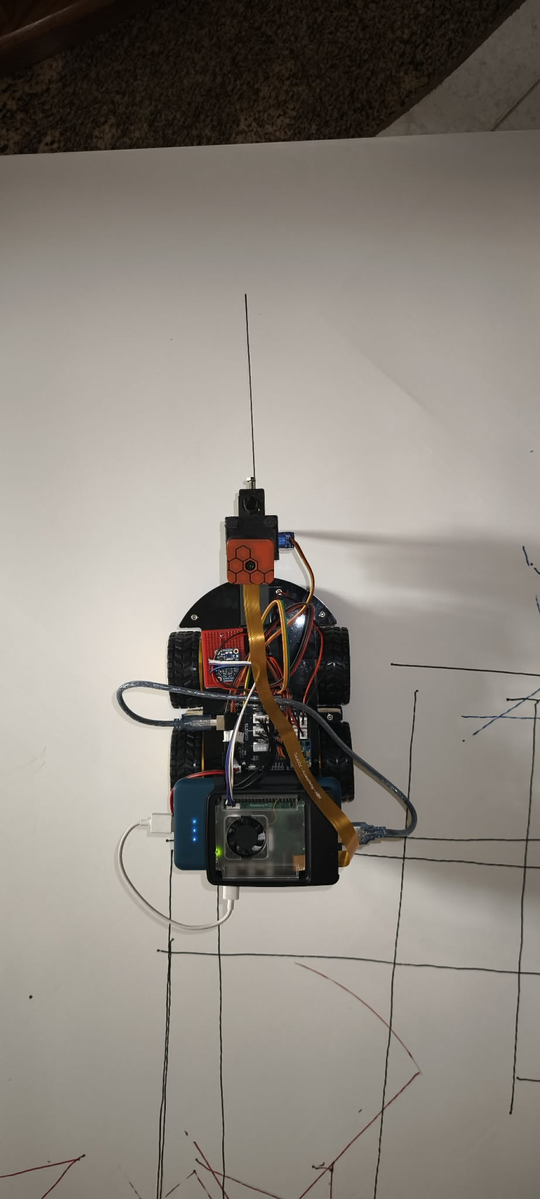
Photos of Tests/Tests Photos/Line/Successful Line.jpg
