Clyde2105/Thesis_FYP/Photos of Tests/Tests Photos/Measurements OpenCV/Circle.jpg

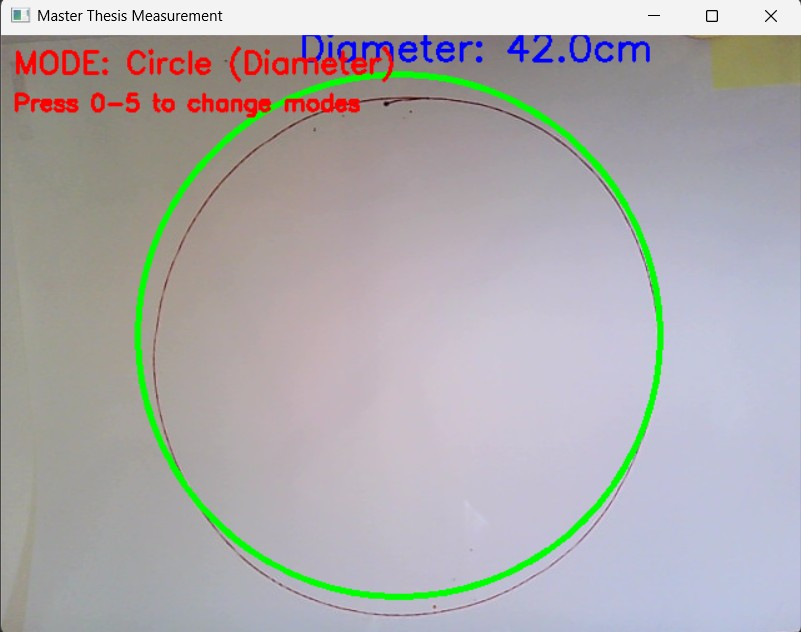
Photos of Tests/Tests Photos/Measurements OpenCV/Circle.jpg
