Clyde2105/Thesis_FYP/Photos of Tests/Tests Photos/Measurements OpenCV/Reference Objects300.jpg

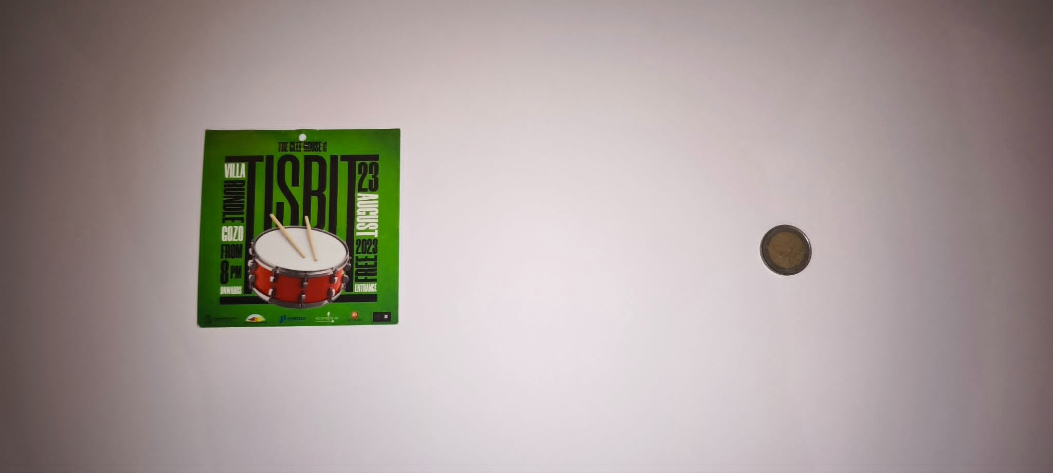
Photos of Tests/Tests Photos/Measurements OpenCV/Reference Objects300.jpg
