Clyde2105/Thesis_FYP/Photos of Tests/Tests Photos/Measurements OpenCV/Star.png

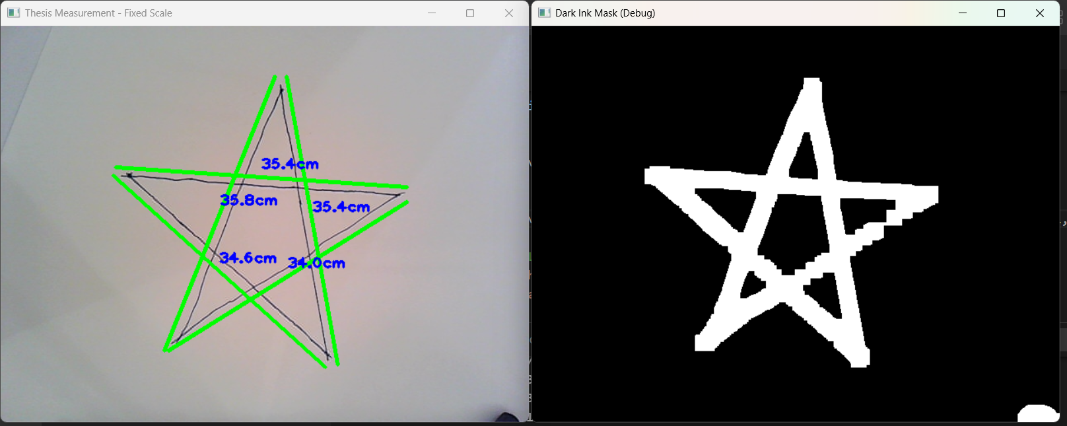
Photos of Tests/Tests Photos/Measurements OpenCV/Star.png
