Clyde2105/Thesis_FYP/Photos of Tests/Tests Photos/Measurements OpenCV/triangle angle measure300.png

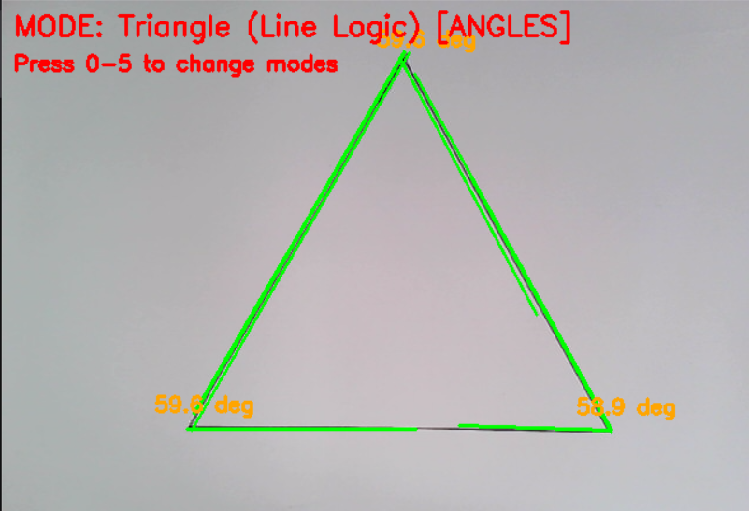
Photos of Tests/Tests Photos/Measurements OpenCV/triangle angle measure300.png
