Clyde2105/Thesis_FYP/Photos of Tests/Tests Photos/Measurements OpenCV/Triangle.png

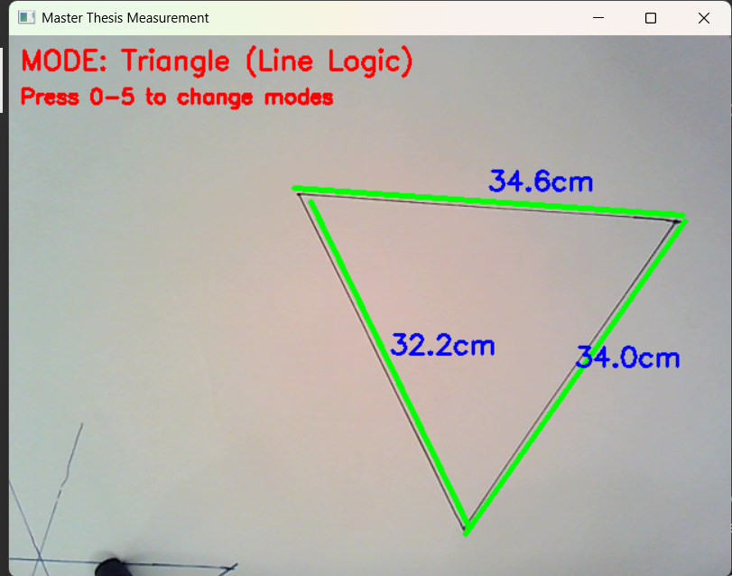
Photos of Tests/Tests Photos/Measurements OpenCV/Triangle.png
