Clyde2105/Thesis_FYP/Photos of Tests/Tests Photos/MediaPipe/Background Light Test300.png

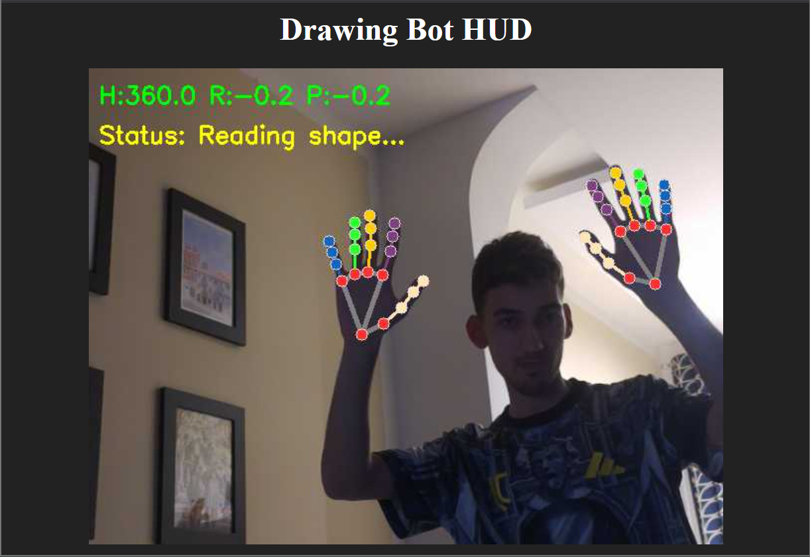
Photos of Tests/Tests Photos/MediaPipe/Background Light Test300.png
