Clyde2105/Thesis_FYP/Photos of Tests/Tests Photos/MediaPipe/Full Light Test300.png

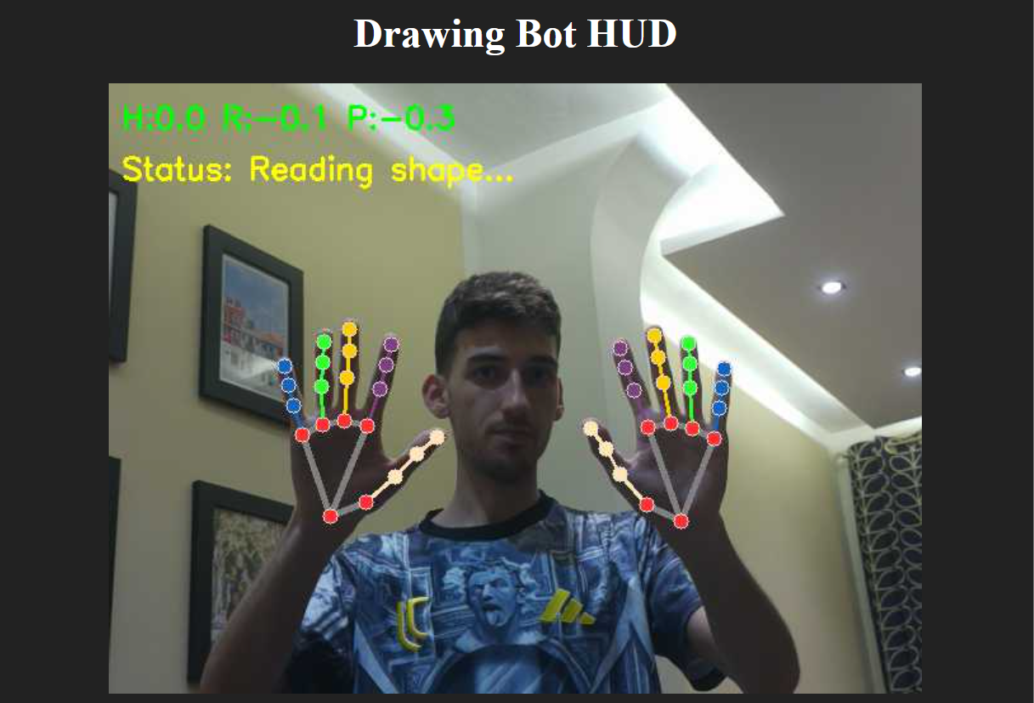
Photos of Tests/Tests Photos/MediaPipe/Full Light Test300.png
