Clyde2105/Thesis_FYP/Photos of Tests/Tests Photos/Rectangle/Rectangle Progress.jpg

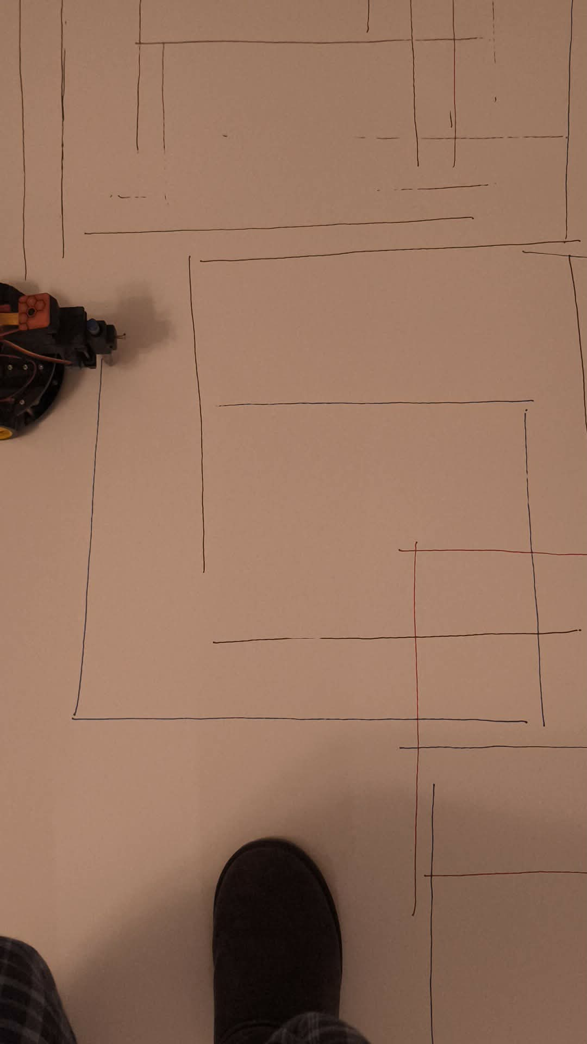
Photos of Tests/Tests Photos/Rectangle/Rectangle Progress.jpg
