Clyde2105/Thesis_FYP/Photos of Tests/Tests Photos/Square/1a68c38b-977b-44fa-96e8-33d461fee69c.jpg

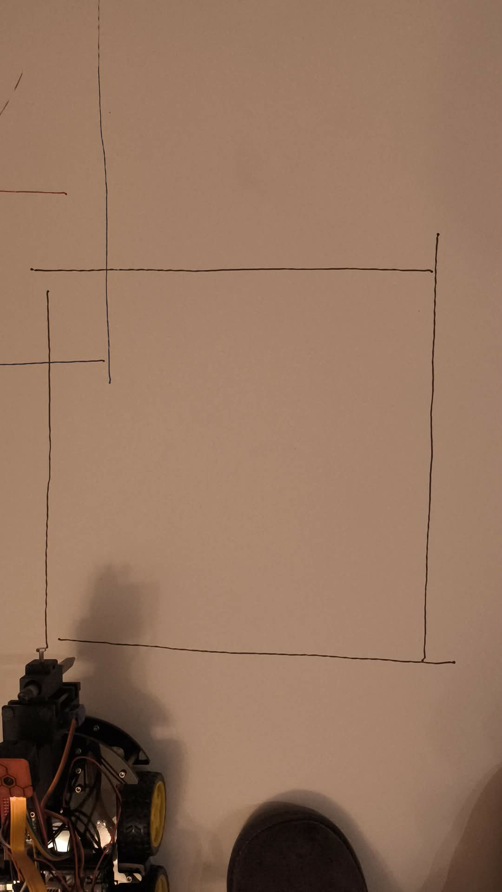
Photos of Tests/Tests Photos/Square/1a68c38b-977b-44fa-96e8-33d461fee69c.jpg
