Clyde2105/Thesis_FYP/Photos of Tests/Tests Photos/Square/64ecf7f8-7c43-42e6-9a29-4498a7ba4135.jpg

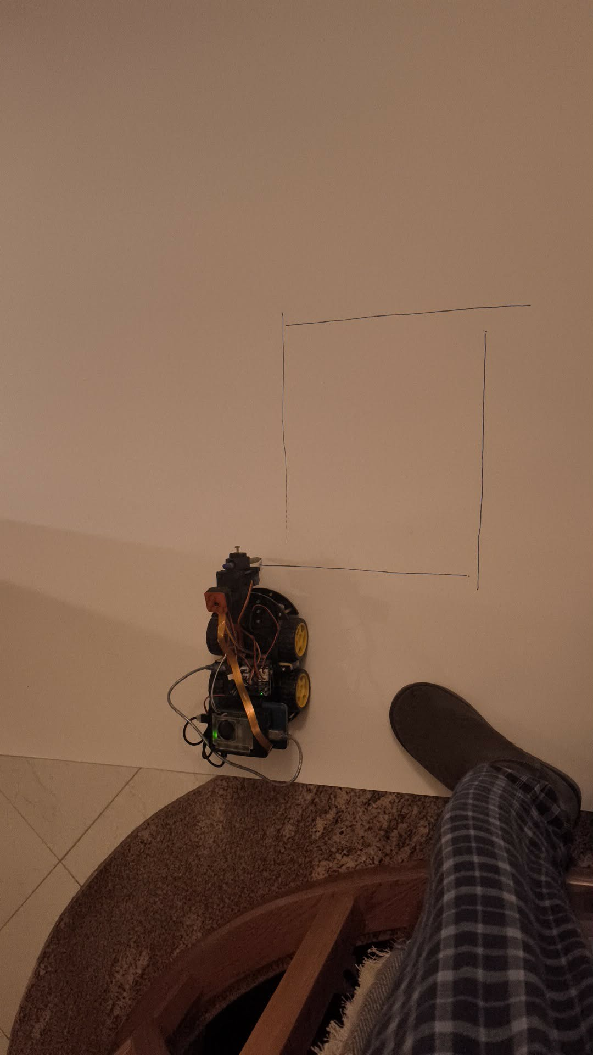
Photos of Tests/Tests Photos/Square/64ecf7f8-7c43-42e6-9a29-4498a7ba4135.jpg
