Clyde2105/Thesis_FYP/Photos of Tests/Tests Photos/Square/79d9f175-fd05-4e84-a43c-baed788e2a0b.jpg

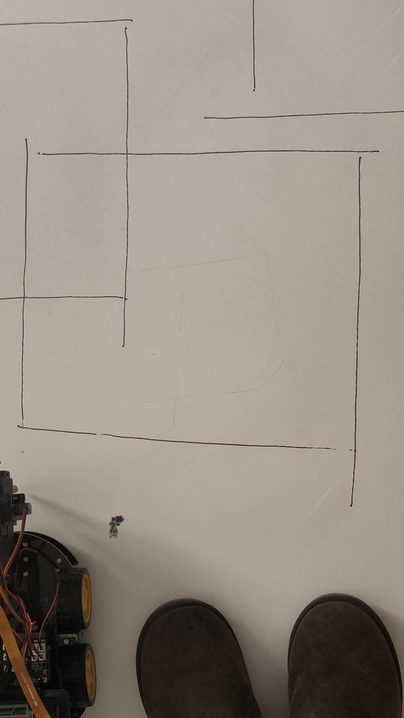
Photos of Tests/Tests Photos/Square/79d9f175-fd05-4e84-a43c-baed788e2a0b.jpg
