Clyde2105/Thesis_FYP/Photos of Tests/Tests Photos/Square/43002cab-3538-4246-b93c-d11135d9b09d.jpg

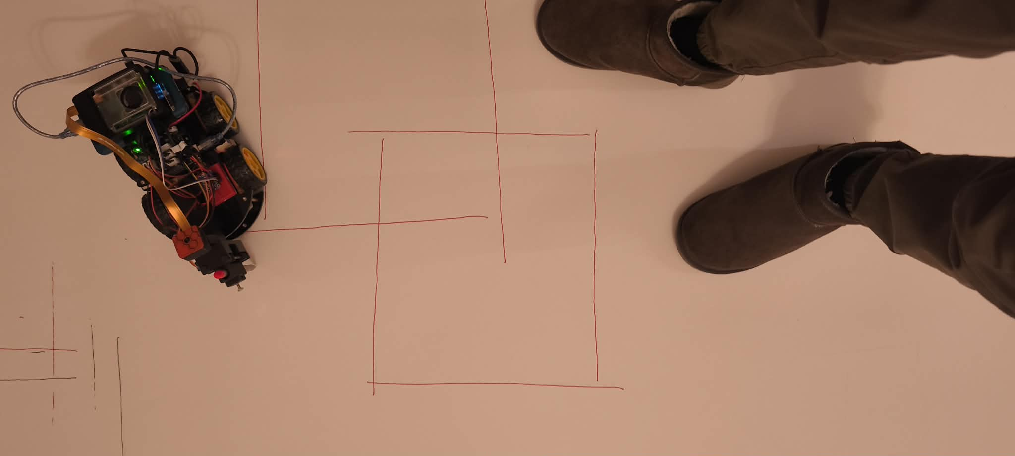
Photos of Tests/Tests Photos/Square/43002cab-3538-4246-b93c-d11135d9b09d.jpg
