Clyde2105/Thesis_FYP/Photos of Tests/Tests Photos/Square/ad683210-cae2-4324-8909-ccc7cfe88664.jpg

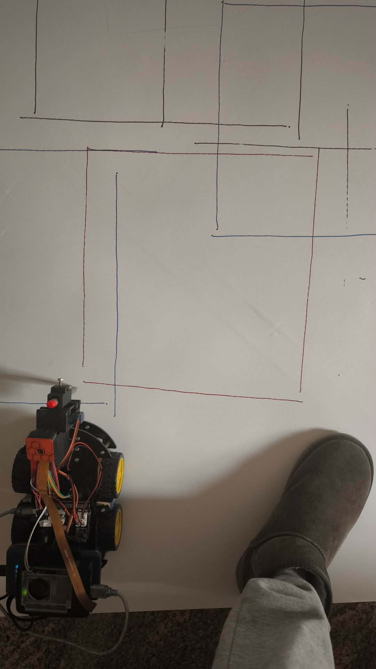
Photos of Tests/Tests Photos/Square/ad683210-cae2-4324-8909-ccc7cfe88664.jpg
