Clyde2105/Thesis_FYP/Photos of Tests/Tests Photos/Square/f69a1ca4-7366-4dac-9f2a-612c33200f27.jpg

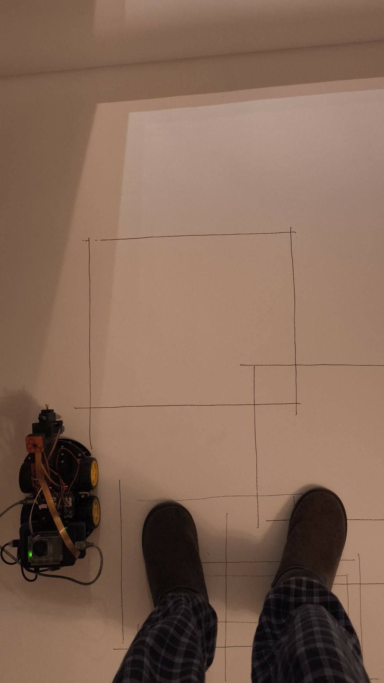
Photos of Tests/Tests Photos/Square/f69a1ca4-7366-4dac-9f2a-612c33200f27.jpg
