Clyde2105/Thesis_FYP/Photos of Tests/Tests Photos/Square/Hash Square300.jpg

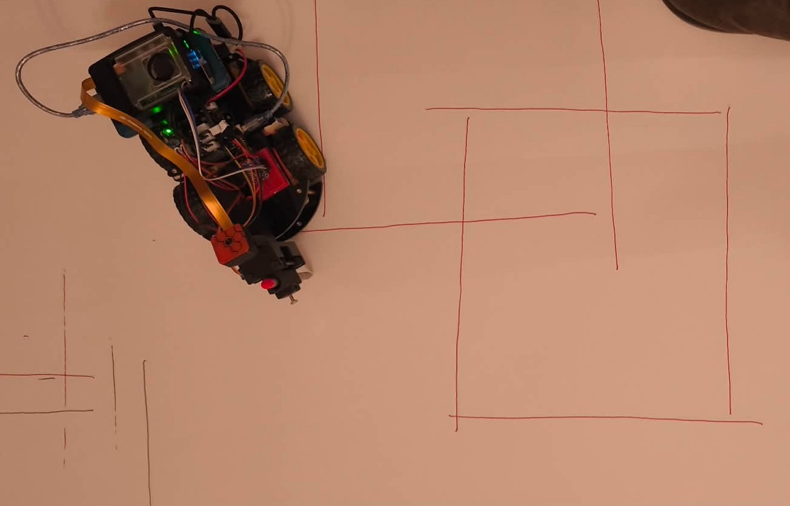
Photos of Tests/Tests Photos/Square/Hash Square300.jpg
