Clyde2105/Thesis_FYP/Photos of Tests/Tests Photos/Square/Square Progress.jpg

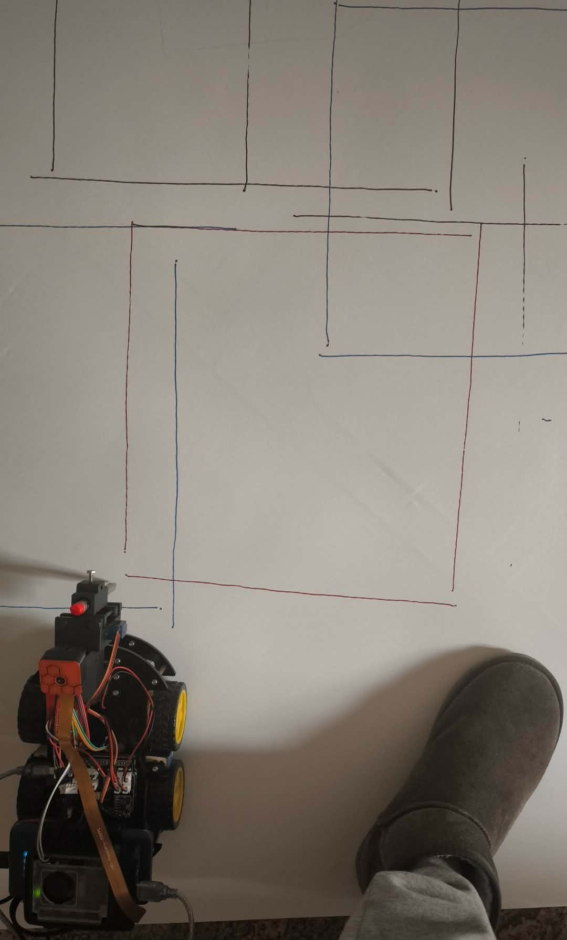
Photos of Tests/Tests Photos/Square/Square Progress.jpg
