Clyde2105/Thesis_FYP/Photos of Tests/Tests Photos/Square/Square Robot 1.jpg

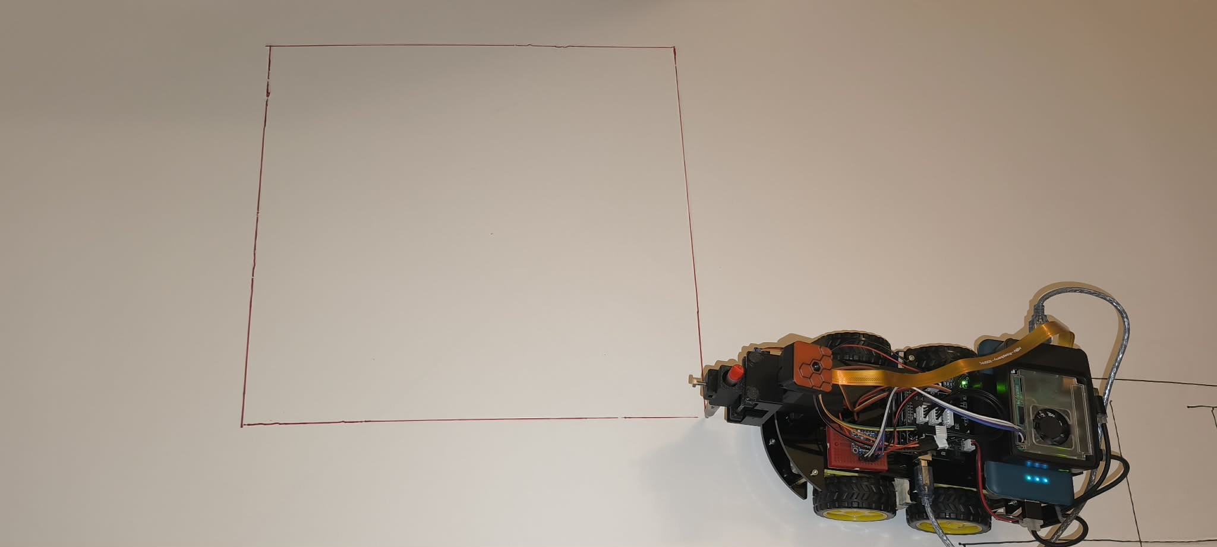
Photos of Tests/Tests Photos/Square/Square Robot 1.jpg
