Clyde2105/Thesis_FYP/Photos of Tests/Tests Photos/Square/Square Robot 2.jpg

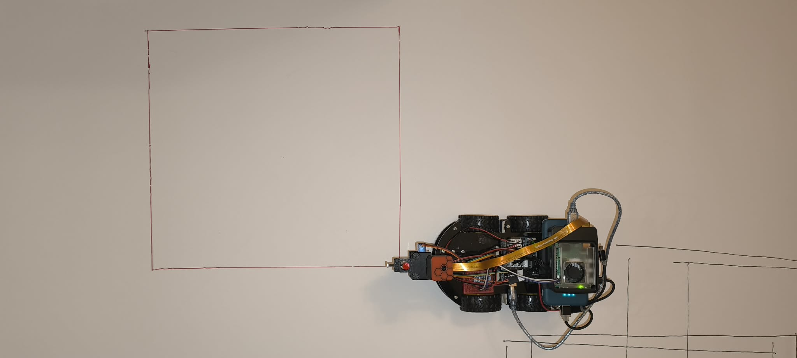
Photos of Tests/Tests Photos/Square/Square Robot 2.jpg
