Clyde2105/Thesis_FYP/Results/Thesis Results/BNO055/Heading Angle vs Time300.png

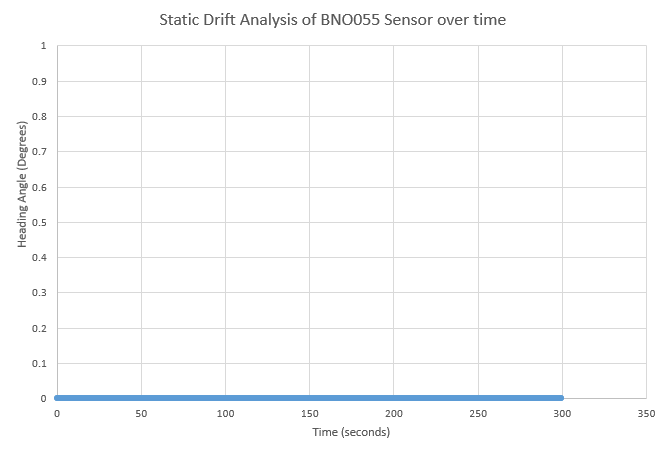
Results/Thesis Results/BNO055/Heading Angle vs Time300.png
