Clyde2105/Thesis_FYP/Results/Thesis Results/LM393/Ticks across 5 Tests.png

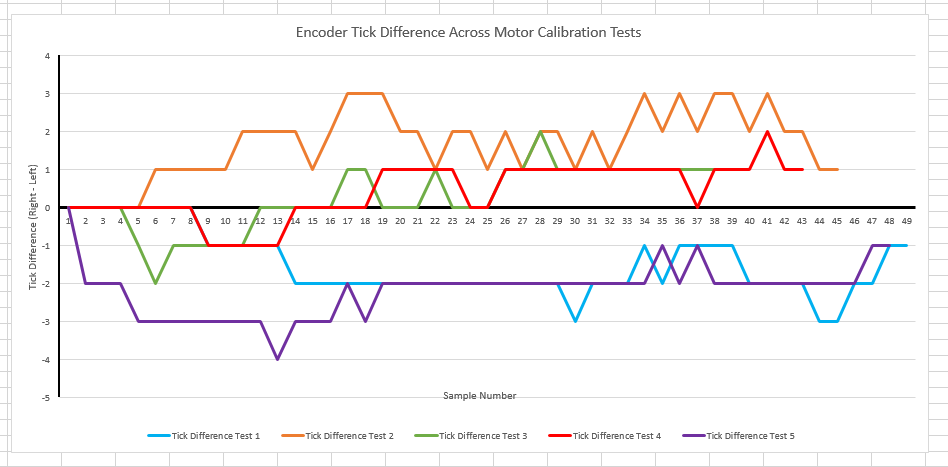
Results/Thesis Results/LM393/Ticks across 5 Tests.png
