Clyde2105/Thesis_FYP/Code/Simulation/config/ros2_control.yaml

controller_manager:
  ros__parameters:
    update_rate: 30
    use_sim_time: true

    diff_drive_controller:
      type: diff_drive_controller/DiffDriveController

    joint_state_broadcaster:
      type: joint_state_broadcaster/JointStateBroadcaster

diff_drive_controller:
  ros__parameters:
    left_wheel_names: ["left_wheel_joint"]
    right_wheel_names: ["right_wheel_joint"]
    wheel_separation: 0.34
    wheel_radius: 0.05
    use_sim_time: true
    use_stamped_vel: false
    publish_rate: 50.0
    base_frame_id: base_link
    odom_frame_id: odom
    enable_odom_tf: true
    open_loop: false
    cmd_vel_timeout: 0.5

joint_state_broadcaster:
  ros__parameters:
    use_sim_time: true
