Clyde2105/Thesis_FYP/(commit log)

2026-02-13 Added Code Folder: BNO055 sensor & Paint Sim -> code files
2026-02-13 Added motor_test arduino code and protractor py code
2026-03-09 Pi Camera Code
2026-03-10 Simulation Codes
    [art_world.sdf, artbot.urdf.xacro, ink_spot.sdf, robot.urdf.xacro, ros2_control.yaml]
2026-05-12 Integrate Arduino for motor control and improve camera handling
    Added serial communication with Arduino for motor control and updated camera thread for better performance.
2026-05-26 Enhance Raspberry Pi 5 justification in README
    Expanded on the rationale for choosing the Raspberry Pi 5 as the high-level controller, detailing its advantages over previous models and the Arduino. Added a hardware comparison matrix to support the decision.
